HillChai/SimpleWarehouse/2_Chapter2_CALIBARATED/TEX/REWRITE.pdf

# 智能仓储系统的开发研究

先进计算与机器人研究所

2023 年 7 月 4 日

目录

1 第二章: 等待校准的秤 | 2

## 1 第二章: 等待校准的秤

从上一章 1.3 节的图像可以看出, 称重结果有些不准, 离真实数据偏差较大, 我们需要进一步校准。从 图像看出, 用直线拟合效果也能接接受。在这一章我们将给出一个可以进行一次校准的秤, 还是在 1.3 节 Calibrate 类上进行修改, 加入 kb 在 arduino 硬盘上读写的操作, 以及将校准后的结果打印在串口。

秤校准的步骤和 1.3 节相比基本类似:

- 1. 获得不准的数据数组;
- 2. 计算拟合系数;
- 3. 输出校准后的结果
1 | class Calibrate {
2 | union coeffience {
3 | unsigned long value_out;
4 | byte value_in[4];
5 | };

6
7 | private:
8 | int pin_SCK, pin_DT, range;
9 | float GapValue;
10 | unsigned long k, b;
11 | unsigned long x[13];
12 | int n;

13
14 | public:
15 | Calibrate();

16
17 | void Get_x_array(unsigned long ADS);
18 | void Get_kb();
19 | unsigned long Output_CalibratedWeight(unsigned long weight);
20 | void kb_Initialize();

21
22 | void setpin_SCKDT(int p1, int p2);
23 | void set_range(int r);
24 | unsigned long Output_Weight(unsigned long ADS);
25 | unsigned long HX711_Read();
26 | };
| 相比 1.3 节添加了两个函数, 修改了一个函数。
| • Get_kb 中加入了写入 arduino 硬盘的操作;
| • Output_CalibratedWeight 输出校准后的读数;
| • kb_Initialize 是从 arduino 硬盘上读取存的 k,b 值。
1 | void Calibrate::Get_kb(){
2 | unsigned long y[n] = {5, 15, 35, 55, 105, 574}, sum_x = 0, sum_y = 0;
3 | for (unsigned long& yi:y)
4 | sum_y+=yi;
5 | for (unsigned long& x_i:x)
6 | sum_x+=x_i;
7 | unsigned long mean_x = sum_x/n, mean_y = sum_y/n;
8 | unsigned long k1=0, k2=0;
9 | for (int i=0; i<n; ++i) {
10 | k1+=x[i]*y[i];
11 | k2+=x[i]*x[i];
12 | }
13 | k = (k1-n*mean_x*mean_y)/(k2-n*mean_x*mean_x);

14 | b = mean_y - mean_x * k;
16 | coeffience k_out;
17 | coeffience b_out;

18
19 | k_out.value_out = k;
20 | b_out.value_out = b;

21
22 | for(int i=4; i<8; i++) //判断是否与上次储存的k相同
23 | if (!(EEPROM.read(i)==k_out.value_in[i-4])) {
24 | Serial.print("newk:");
25 | Serial.println(k);
26 | for (int j=i; j<8; j++)
27 | EEPROM.write(j, k_out.value_in[j-4]);
28 | break;
29 | }

30
31 | for(int i=8; i<12; i++) //判断是否与上次储存的b相同
32 | if (!(EEPROM.read(i)==b_out.value_in[i-8])) {
33 | Serial.print("newb:");
34 | Serial.println(b);
35 | for (int j=8; j<12; j++)
36 | EEPROM.write(j, b_out.value_in[j-8]);
37 | break;
38 | }
39 | };
| 在得到 k,b 后, 用共用体 k_out, b_out 存储 k, b 值, 通过 for 循环与 arduino 上对应地址存的 k(4 7),
| b(8 11) 值比较, 如果不一样则从当前位置写入。
1 | coeffience k_out;
2 | coeffience b_out;

3
4 | k_out.value_out = k;
5 | b_out.value_out = b;

6
7 | for(int i=4; i<8; i++) //判断是否与上次储存的k相同
8 | if (!(EEPROM.read(i)==k_out.value_in[i-4])) {
9 | Serial.print("newk:");
10 | Serial.println(k);
11 | for (int j=i; j<8; j++)
12 | EEPROM.write(j, k_out.value_in[j-4]);
13 | break;
14 | }

15
16 | for(int i=8; i<12; i++) //判断是否与上次储存的b相同
17 | if (!(EEPROM.read(i)==b_out.value_in[i-8])) {
18 | Serial.print("newb:");
19 | Serial.println(b);
20 | for (int j=8; j<12; j++)
21 | EEPROM.write(j, b_out.value_in[j-8]);
22 | break;
23 | }
| 校准结果是在第一章中 Output_Weight 基础上, 加入了系数 k,b 的作用, 返回校准后的质量。
1 | unsigned long Calibrate::Output_CalibratedWeight(unsigned long ADS){
2 | return k*Output_Weight(ADS)+b;
3 | };
| 如果之前校准过, 可以通过 kb_Initialize() 读取 arduino 上存的 k,b 值:
1 | void PressureSensor::kb_Initialize() {

2 | coeffience k_arduino;
3 | coeffience b_arduino;
5 | for(int i=4; i<8; i++) {
6 | k_arduino.value_in[i-4] = EEPROM.read(i);
7 | b_arduino.value_in[i-4] = EEPROM.read(i+4);
8 | }

9
10 | k = k_arduino.value_out;
11 | b = b_arduino.value_out;
12 | Serial.print("k:␣");
13 | Serial.println(k);
14 | Serial.print("b:␣");
15 | Serial.println(b);
16 | };
| arduino 上 k 对应的地址是 4 到 7, b 对应的地址是 8 到 11。首先创建两个共用体 k_arduino,
| b_arduino。
1 | coeffience k_arduino;
2 | coeffience b_arduino;
| 然后用一个 for 循环读对应地址上信息存放到对应共用体中。
1 | for(int i=4; i<8; i++) {
2 | k_arduino.value_in[i-4] = EEPROM.read(i);
3 | b_arduino.value_in[i-4] = EEPROM.read(i+4);
4 | }
| 最后是更新变量 k,b, 并在串口打印。
1 | k = k_arduino.value_out;
2 | b = b_arduino.value_out;
3 | Serial.print("k:␣");
4 | Serial.println(k);
5 | Serial.print("b:␣");
6 | Serial.println(b);

### 1.1 Calibrate.ino

1 | #include "Surface.h"
2 | #include "Calibrate.h"

3
4 | Surface YL_Surface;
5 | Calibrate YL_Calibrated;

6
7 bool flag=1;

8
9 | void setup() {
10 | Serial.begin(9600);
11 | YL_Calibrated.setpin_SCKDT(4, 5);
12 | YL_Calibrated.set_range(20);
13 | YL_Calibrated.kb_Initialize();
14 | }

15
16 | void loop() {
17 | if (flag) {
18 | YL_Calibrated.Get_x_array(YL_Surface.Get_Surface());
19 | YL_Calibrated.Get_kb();
20 | flag=0;
21 | }

23 | unsigned long CalibratedWeight = YL_Calibrated.Output_CalibratedWeight(YL_Surface.
| Get_Surface());
24 | Serial.println(CalibratedWeight);
25 | delay(1000);
26 | }
| 主程序分为三部分:
| 第一部分: 导入头文件 Calibrate.h, Surface.h, 实例化 Surface 类. Oled 类, flag=1 方便主循环调用一次校
| 准;
1 | #include "Surface.h"
2 | #include "Calibrate.h"

3
4 | Surface YL_Surface;
5 | Calibrate YL_Calibrated;

6
7 | bool flag=1;
| 第二部分: 在 setup 函数里初始化波特率 9600, 与 Arduino 串口通信的波特率保持一致;
1 | Serial.begin(9600);
| 设置与 SCK 和 DT 相连的 arduino 引脚 4 和 5, 设置当前压力传感器的量程 20. kb_Initialize() 读
| 取之前存的 k,b 值:
1 | YL_Calibrated.setpin_SCKDT(4, 5);
2 | YL_Calibrated.set_range(20);
3 | YL_Calibrated.kb_Initialize();
| 第三部分: flag 为 1 时进行一次校准, 并在校准后 flag 赋值为 0, 避免重复校准。先通过 Get_x_array 获
| 得不准的读数数组, 再通过 Get_kb 获得拟合系数, 最后由 Output_CalibratedWeight 计算校准后的结果。
1 | if (flag) {
2 | YL_Calibrated.Get_x_array(YL_Surface.Get_Surface());
3 | YL_Calibrated.Get_kb();
4 | flag=0;
5 | }

6
7 | unsigned long CalibratedWeight = YL_Calibrated.Output_CalibratedWeight(YL_Surface.
| Get_Surface());
8 | Serial.println(CalibratedWeight);
9 | delay(1000);
10 | }
