HillChai/SimpleWarehouse/4_Chapter4_COMMUNICATION/TEX/REWRITE.pdf

# 智能仓储系统的开发研究

先进计算与机器人研究所

2023 年 7 月 9 日

目录

1 第四章: I2C 通信 | 2

## 1 第四章: I2C 通信

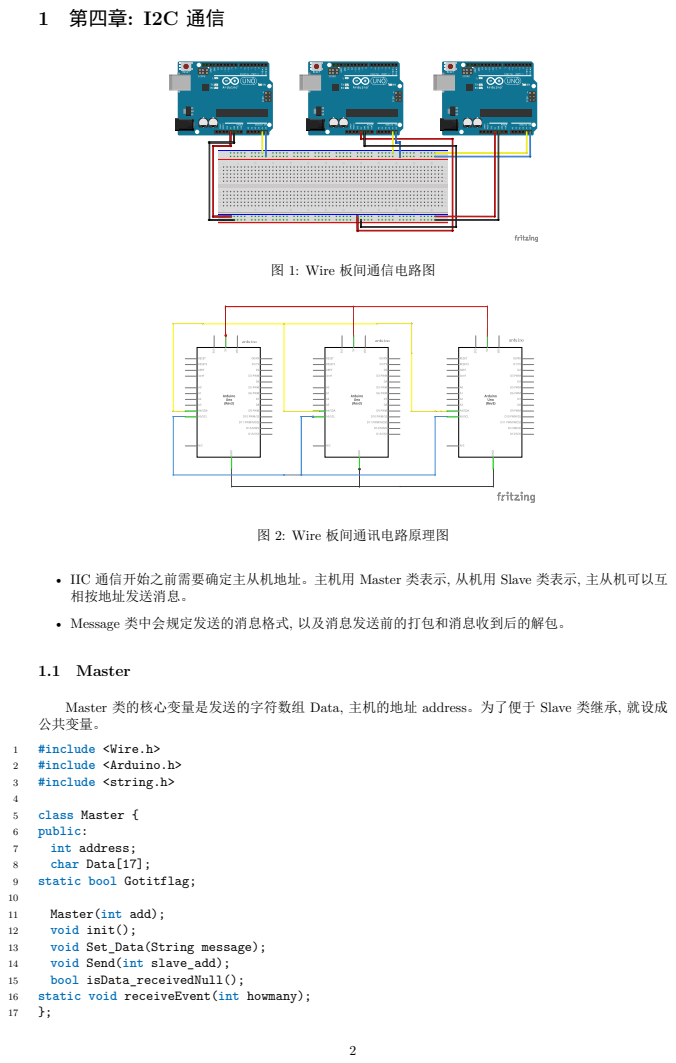
[picture p5: page 2]
图 1: Wire 板间通信电路图; 图 2: Wire 板间通讯电路原理图; 1.1 Master; #include <Wire.h>; #include <Arduino.h>; #include <string.h>; class Master {; public:; int address;; char Data[17];; static bool Gotitflag;; Master(int add);; void init();; void Set_Data(String message);; void Send(int slave_add);; bool isData_receivedNull();; static void receiveEvent(int howmany);

• IIC 通信开始之前需要确定主从机地址。主机用 Master 类表示, 从机用 Slave 类表示, 主从机可以互
相按地址发送消息。

• Message 类中会规定发送的消息格式, 以及消息发送前的打包和消息收到后的解包。

Master 类的核心变量是发送的字符数组 Data, 主机的地址 address。为了便于 Slave 类继承, 就设成
公共变量。

在构造函数 Master 中, 通过赋值更新地址 address。

1 | Master::Master(int add){
2 | address=add;
3 | };
| 由于 Wire.begin() 不能在 setup 之前运行, 所以在初始化函数 init 中初始化了 IIC 通信, 并绑定了回
| 调函数 receiveEvent, 在 IIC 收到消息时调用。
1 | void Master::init() {
2 | Wire.begin(address);
3 | Wire.onReceive(receiveEvent);
4 | memset(Data, '0', 16);
5 | };
| Set_Data 通过赋值更新 Data。
1 | void Master::Set_Data(String message) {
2 | for (int i=0; i<message.length(); i++)
3 | Data[i] = message[i];
4 | };
| Send 是主机向地址为 slave_add 的从机发送消息 Data, 为了方便判断是否发送了, 发送成功则会在
| 串口打印”Sended”, 否则就会卡住, 不打印”Sended”。
1 | void Master::Send(int slave_add) {
2 | Wire.beginTransmission(slave_add);
3 | Wire.write(Data);
4 | Wire.endTransmission(slave_add);
5 | Serial.println("Sended");
6 | };
| 为了确认从机是否收到完整消息, 在下一节从机 Slave 类中会提到, 当 Slave 确认收到了完整消息, 就
| 会向主机发送一个字符串”Gotit!”。那么相应地, 主机也需要判断接收到的是不是”Gotit!”。如果是则会将
| 一个静态变量 Gotitflag 置为 1, 在演示代码 Master.ino 中, 会再次提到 Gotitflag。
1 | bool Master::Gotitflag = 0;

2
3 | void Master::receiveEvent(int howmany){
4 | String standard = "Gotit!";
5 | String buffer = "";
6 | while (Wire.available())
7 | buffer += (char) Wire.read();
8 | Serial.println(buffer);
9 | for (int i=0; i<6; i++)
10 | if (buffer[i] == standard[i])
11 | Gotitflag = 1;
12 | };

### 1.1.1 Master.ino

演示代码实现的是地址为 8 的主机会一直向地址为 11 的从机发送字符串”SS0812345RR”, 直到 Gotitflag 置为 1。Gotitflag 置为 1 意味着从机发送回了收到的信号。则在串口打印结束发送。

1 #include "Master.h"

2
3 Master master(8);

4
5 | void setup() {
6 | Serial.begin(9600);
7 | master.init();
8 | master.Set_Data("SS0812345RR");

11 | void loop() {
12 | while (!master.Gotitflag) {
13 | master.Send(11);
14 | delay(5000);
15 | }
16 | Serial.println("endsending");
17 | delay(500);
18 | }

### 1.2 Slave

| Slave 类的核心变量是储存主机发送过来的完整消息 Data_received, 储存主机的地址 address_to_send。
| Slave 储存自身的地址变量是从 Master 类中继承过来的。
1 | #include "Master.h"

2
3 | class Slave : public Master{
4 | private:
5 | static String Data_received;

6
7 | public:
8 | static int address_to_send;

9
10 | Slave(int add);
11 | void init();
12 | void feedback();
13 | static void slave_receiveEvent(int howmany);
14 | };
| 构造函数 Slave() 完全继承于 Master 的构造函数
1 | Slave::Slave(int add) : Master(add) {};
| 初始化需要重定义, 因为回调函数 slave_receiveEvent 与 Master 类的 receiveEvent 不一样。
1 | void Slave::init(){
2 | Wire.begin(address);
3 | Wire.onReceive(slave_receiveEvent);
4 | memset(Data, '0', 16);
5 | }
| 从机的回调函数 slave_receiveEvent 需要在有消息的时候判断, 是不是”SS” 开头, 如果是, 则开始读,
| 并更新 Data_received。并在读到”RR” 时, 结束更新 Data_received。结束更新后, 需要读取指定位置表
| 示主机地址的字符。这里退出 while 循环需要严格以 Wire.available() 为准, 如果是读到完整消息就直接退
| 出, 很可能出现附录中第一节消息堵塞之陷入死循环。
1 | void Slave::slave_receiveEvent(int howmany){
2 | memset(&Data_received, 0, Data_received.length());
3 | bool addressflag = 1;
4 | while(Wire.available()) {
5 | Serial.println("connect");
6 | if (Data_received[0] != 'S' && Data_received[1] != 'S') {
7 | char start1 = (char) Wire.read();
8 | if (start1 == 'S') {
9 | char start2 = (char) Wire.read();
10 | if (start2 == 'S') {
11 | Data_received += 'S';
12 | Data_received += 'S';

17 | if (Data_received[0] == 'S' && Data_received[1] == 'S') {
18 | if (Data_received[Data_received.length()-2]=='R' && Data_received[Data_received.
| length()-1]=='R') {
19 | Wire.read();
20 | if (addressflag) {
21 | String address;
22 | for (int i=0; i<2; i++) address += Data_received[2+i];
23 | address_to_send = address.toInt();
24 | addressflag = 0;
25 | }
26 | } else {
27 | char end1 = (char) Wire.read();
28 | Data_received += end1;
29 | // Serial.println(Data_received);
30 | }
31 | }
32 | }
33 | Serial.println(address_to_send);
34 | };
| 在上一节 Master 类中有提到”Gotit!” 作为从机读到完整消息的反馈。这里 address_to_send 是先设
| 为不可能有的地址 99, 在 slave_receiveEvent 中, 如果接收到完整消息, 则 address_to_send 会更新为有
| 效地址, 所以利用 address_to_send 作为要不要发送”Gotit!” 的 flag。
1 | void Slave::feedback() {
2 | if (address_to_send!=99) {
3 | Wire.beginTransmission(address_to_send);
4 | Wire.write("Gotit!");
5 | Wire.endTransmission(address_to_send);
6 | address_to_send = 99;
7 | }
8 | };

### 1.2.1 Slave.ino

演示代码是实现 slave 接收到 IIC 通信传来得的消息后, 反馈”Gotit!” 给发送过来的主机。

1 #include "Slave.h"

2
3 Slave slave(11);

4
5 | void setup() {
6 | Serial.begin(9600);
7 | slave.init();
8 | }

9
10 | void loop() {
11 | slave.feedback();
12 | delay(500);
13 | }

### 1.3 Message

| Message 类的核心变量有 5 个, 储存完整消息的字符数组 Data, 物品种类 Type, 发送方地址 De-
| viceAddress, 物品种类 Amount, 物品总质量 TotalMass。关于字符数组的长度设置原因详见本章附录。由
| 于 unsigned long 方便转化成 char*, 而 char* 不便于计算有效长度, 故需要在转化前就通过数值确定转化
| 后的长度, 储存在 totalmass_str_len 中。

1 | #include <Arduino.h>
2 | #include <string.h>
4 | class Message {
5 | private:
6 | char Data[17];
7 | char Type[3];
8 | int DeviceAddress, Amount;
9 | unsigned long TotalMass;
10 | int totalmass_str_len;

11
12 | public:
13 | Message();

14
15 | void Set_Messagevalues(char *type, int device, int amount, unsigned long totalmass);
16 | void pack();
17 | void Output_pack();

18
19 | void Set_Data(char* message);
20 | void unpack();
21 | void Output_unpack();
22 | };
| 构造函数里会对五个核心变量储存完整消息的字符数组 Data, 物品种类 Type, 发送方地址 DeviceAd-
| dress, 物品种类 Amount, 物品总质量 TotalMass 进行赋值。这里规定消息前两位和后两位是标志位。”SS”
| 表示消息开头, ”RR” 表示消息结尾。
1 | Message::Message() {
2 | memset(Data, '0', 16);
3 | Data[0] = 'S';
4 | Data[1] = 'S';
5 | Data[14] = 'R';
6 | Data[15] = 'R';
7 | Type[0] = '0';
8 | Type[1] = '0';
9 | DeviceAddress = 0;
10 | Amount = 0;
11 | TotalMass = 0;
12 | }
| Set_Messagevalues 通过赋值更新物品种类 Type, 发送方地址 DeviceAddress, 物品种类 Amount, 物
| 品总质量 TotalMass, 长度 totalmass_str_len。
1 | void Message::Set_Messagevalues(char *type, int device, int amount, unsigned long
| totalmass) {
2 | Type[0] = type[0]; //物品种类
3 | Type[1] = type[1];

4
5 | DeviceAddress = device;
6 | Amount = amount;
7 | TotalMass = totalmass;
8 | if (totalmass<10) totalmass_str_len = 1;
9 | else if (totalmass<100) totalmass_str_len = 2;
10 | else if (totalmass<1000) totalmass_str_len = 3;
11 | else if (totalmass<10000) totalmass_str_len = 4;
12 | };
| pack 用物品种类 Type, 发送方地址 DeviceAddress, 物品种类 Amount, 物品总质量 TotalMass 更新
| Data。unsigned long 不能用 String 强制转换, 但可以用 sprintf 转化成 char*。
1 | void Message::pack() {
2 | String device_str = String(DeviceAddress);
3 | String amount_str = String(Amount);

4 | char totalmass_str[5];
5 | sprintf(totalmass_str, "%d", TotalMass);
7 | for (int i=0; i<2; i++)
8 | Data[2+i] = Type[i]; //物品种类

9
10 | int device_str_len = device_str.length();
11 | if (device_str_len == 1) { | //发送方地址
12 | Data[5] = device_str[0];
13 | }
14 | else if (device_str_len == 2) {
15 | Data[4] = device_str[0];
16 | Data[5] = device_str[1];
17 | }

18
19 | int amount_str_len = amount_str.length(); //物品数量
20 | if (amount_str_len == 1) Data[9] = amount_str[0];
21 | else if (amount_str_len == 2)
22 | for (int i=0; i<2; i++) Data[8+i] = amount_str[i];
23 | else if (amount_str_len == 3)
24 | for (int i=0; i<3; i++) Data[7+i] = amount_str[i];
25 | else if (amount_str_len == 4)
26 | for (int i=0; i<4; i++) Data[6+i] = amount_str[i];

27
28 | if (totalmass_str_len == 1) //物品总质量
29 | Data[13] = totalmass_str[0];
30 | else if (totalmass_str_len == 2)
31 | for (int i=0; i<2; i++) Data[12+i] = totalmass_str[i];
32 | else if (totalmass_str_len == 3)
33 | for (int i=0; i<3; i++) Data[11+i] = totalmass_str[i];
34 | else if (totalmass_str_len == 4)
35 | for (int i=0; i<4; i++) Data[10+i] = totalmass_str[i];
36 | };

Output_pack 将打包后的 Data 打印在串口。

1 | void Message::Output_pack() {
2 | Serial.print("Data:");
3 | Serial.println(Data);
4 | };
| Set_Data 通过赋值更新 Data。
1 | void Message::Set_Data(char* message) {
2 | for (int i=2; i<14; i++)
3 | Data[i]=message[i];
4 | }

pack 用 Data 更新物品种类 Type, 发送方地址 DeviceAddress, 物品种类 Amount, 物品总质量 Total-Mass。中间用字符串 device_str, amount_str, tm_str 过渡，然后用 toInt 转化成数值。

1 | void Message::unpack() {
2 | String device_str, amount_str;
3 | char totalmass_str[5];

4
5 | for (int i=0; i<2; i++)
6 | Type[i] = Data[2+i];

7
8 | for (int i=0; i<2; i++)
9 | device_str += Data[4+i];
10 | DeviceAddress = device_str.toInt();
12 | for (int i=0; i<4; i++)

13 | amount_str += Data[6+i];
14 | Amount = amount_str.toInt();
16 | String tm_str;
17 | for (int i=10; i<14; i++)
18 | tm_str += Data[i];
19 | TotalMass = tm_str.toInt();
20 | };
| Output_unpack 将打包后的物品种类 Type, 发送方地址 DeviceAddress, 物品种类 Amount, 物品总
| 质量 TotalMass 打印在串口。
1 | void Message::Output_unpack() {
2 | Serial.print("Type:");
3 | Serial.println(Type);
4 | Serial.print("DeviceAddress:");
5 | Serial.println(DeviceAddress);
6 | Serial.print("Amount:");
7 | Serial.println(Amount);
8 | Serial.print("TotalMass:");
9 | Serial.println(TotalMass);
10 | };

### 1.3.1 Message.ino

演示代码 1 是实现消息发送前的打包:

1 #include "Message.h"

2
3 Message message;

4
5 | char type[2] = {'0', '3'}; //unpack
6 | int address = 8;
7 | int num = 321;
8 | unsigned long totalmass=19;

9
10 | void setup() {
11 | Serial.begin(9600);
12 | message.Set_Messagevalues(type, address, num, totalmass); //pack
13 | message.pack();
14 | }

15
16 | void loop() {
17 | message.Output_pack(); //pack
18 | delay(500);
19 | }
| 演示代码 2 是实现消息收到后的解包:
1 | #include "Message.h"

2
3 Message message;

4
5 | char data[17] = {'S','S','0','4','0','9','0','5','0','5','2','0','0','0','R','R'}; //
| pack

6
7 | void setup() {
8 | Serial.begin(9600);
9 | message.Set_Data(data); //unpack
10 | message.unpack();

13 | void loop() {
14 | message.Output_unpack(); //unpack
15 | delay(500);
16 | }

### 1.4 附录

| 1.4.1 IIC 通信之消息堵塞
| 遇到过的消息堵塞有两种情况。
| • 接发消息一方陷于死循环;
| • 主从机同时用 Wire.beginTransmis() 向对方发消息。
| 比如, 主机发消息是一个字符一个字符发的, 而从机是通过 Wire.read() 一个字符一个字符读的。如果从
| 机一直判断当前读取的字符是不是所需要的字符而不用 Wire.read() 读取的话, 就会造成死循环。只有用
| Wire.read() 读完了上一次发送的消息里的所有字符, 才能读到下一次发送的消息。
| 1.4.2 字符数组的长度
| 字符数组的长度这里要设置的比实际储存的长度长, 如果字符数组的长度这里要设置的比实际储存的
| 长度一样的话, 会出现问题, 比如, Type 字符数组在 Data 字符数组的后面声明的话, 当 Type 在某一方法
| 函数里赋值的时候, 会使得 Data 字符数组的结尾追加 Type 新赋值的字符。而当字符数组的长度这里要
| 设置的比实际储存的长度长时, 字符数组中未赋值的部分会自动填充结尾终止符斜杠 0, 这样就不会赋值
| 时互相影响。
