HillChai/SimpleWarehouse/5_Chapter5_RC522/TEX/REWRITE.pdf

# 智能仓储系统的开发研究

先进计算与机器人研究所

2023 年 7 月 4 日

目录

1 第五章: 射频识别技术 (RFID-RC522) | 2

## 1 第五章: 射频识别技术 (RFID-RC522)

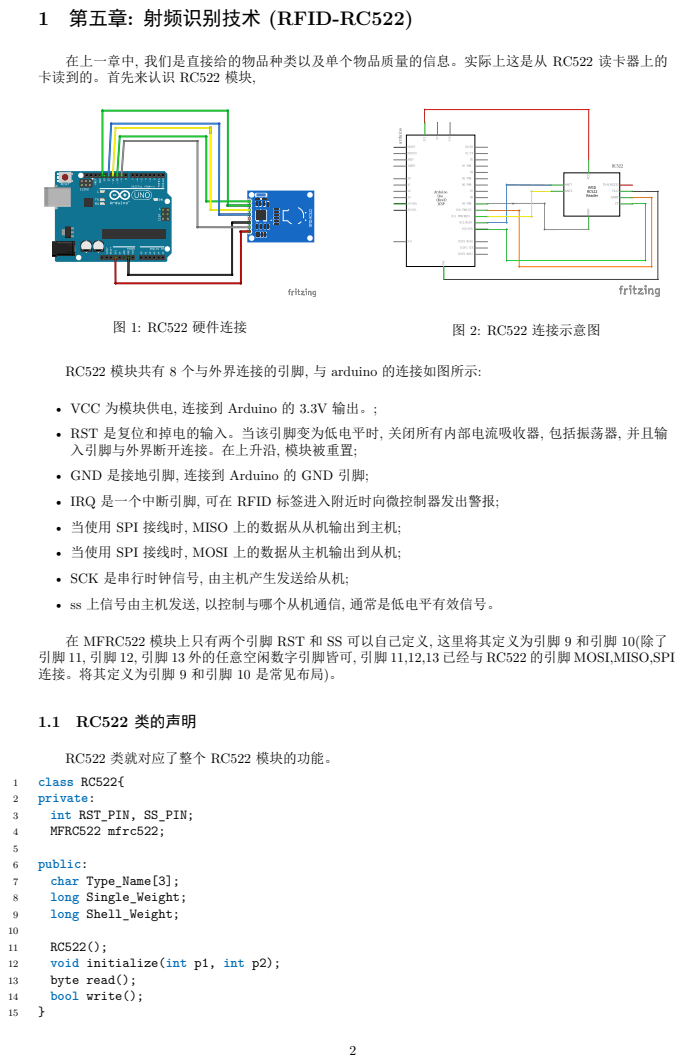
[picture p6: page 2]
图 1: RC522 硬件连接; 图 2: RC522 连接示意图; 1.1 RC522 类的声明; RC522 类就对应了整个 RC522 模块的功能。; class RC522{; private:; int RST_PIN, SS_PIN;; MFRC522 mfrc522;; public:; char Type_Name[3];; long Single_Weight;; long Shell_Weight;; void initialize(int p1, int p2);; byte read();; bool write();

在上一章中, 我们是直接给的物品种类以及单个物品质量的信息。实际上这是从 RC522 读卡器上的
卡读到的。首先来认识 RC522 模块,

RC522 模块共有 8 个与外界连接的引脚, 与 arduino 的连接如图所示:

• VCC 为模块供电, 连接到 Arduino 的 3.3V 输出。;
• RST 是复位和掉电的输入。当该引脚变为低电平时, 关闭所有内部电流吸收器, 包括振荡器, 并且输
入引脚与外界断开连接。在上升沿, 模块被重置;
• GND 是接地引脚, 连接到 Arduino 的 GND 引脚;
• IRQ 是一个中断引脚, 可在 RFID 标签进入附近时向微控制器发出警报;
• 当使用 SPI 接线时, MISO 上的数据从从机输出到主机;
• 当使用 SPI 接线时, MOSI 上的数据从主机输出到从机;
• SCK 是串行时钟信号, 由主机产生发送给从机;
• ss 上信号由主机发送, 以控制与哪个从机通信, 通常是低电平有效信号。

在 MFRC522 模块上只有两个引脚 RST 和 SS 可以自己定义, 这里将其定义为引脚 9 和引脚 10(除了
引脚 11, 引脚 12, 引脚 13 外的任意空闲数字引脚皆可, 引脚 11,12,13 已经与 RC522 的引脚 MOSI,MISO,SPI
连接。将其定义为引脚 9 和引脚 10 是常见布局)。

- 私有变量: RST_PIN, SS_PIN 分别是与 RC522 的 RST,SS 连接的 arduino 引脚;
- 公共变量: Type_Name, Single_Weight, Shell_Weight 是储存从读卡器中读到的物品种类, 单个物 品质量, 每一层物品质量;

默认构造函数:

1 | RC522::RC522(){};
| 初始化函数用于引脚的赋值, 初始化 SPI 通信, 初始化 MFRC522 类。
1 | void RC522::initialize(int p1, int p2){
2 | RST_PIN=p1;
3 | SS_PIN=p2;
4 | SPI.begin();
5 | mfrc522 = MFRC522(SS_PIN, RST_PIN);
6 | mfrc522.PCD_Init();
7 | };

### 1.2 读卡模式

| 将下述代码烧录运行, 就做好了读卡准备。
1 | byte RC522::read(){
2 | // init the read state
3 | byte read_state = 0;
4 | //default key
5 | MFRC522::MIFARE_Key key;
6 | for (byte i = 0; i < 6; ++i) key.keyByte[i] = 0xFF;
7 | //some variables we need
8 | byte block;
9 | byte len;
10 | MFRC522::StatusCode status;
11 | //-------------------------------------------
12 | // Reset the loop if no new card present on the sensor/reader. This saves the entire
| process when idle.
13 | if ( ! mfrc522.PICC_IsNewCardPresent()) {
14 | return read_state;
15 | }
16 | // Select one of the cards
17 | if ( ! mfrc522.PICC_ReadCardSerial()) {
18 | return read_state ;
19 | }
20 | // read one card
21 | read_state = 1;
22 | Serial.println(F("**Card␣Detected:**"));
23 | //-------------------------------------------
24 | // mfrc522.PICC_DumpDetailsToSerial(&(mfrc522.uid)); //dump some details about the
| card
25 | // mfrc522.PICC_DumpToSerial(&(mfrc522.uid)); //uncomment this to see all blocks in
| hex
26 | //-------------------------------------------

27
28 | byte buffer1[18];
29 | block = 1;
30 | len = 18;
31 | //------------------------------------------- GET TYPE NAME
32 | status = mfrc522.PCD_Authenticate(MFRC522::PICC_CMD_MF_AUTH_KEY_A, block, &key, &(
| mfrc522.uid)); //line 834 of MFRC522.cpp file
33 | if (status != MFRC522::STATUS_OK) {
34 | Serial.print(F("Authentication␣failed:␣"));

35 | Serial.println(mfrc522.GetStatusCodeName(status));
36 | return read_state;
37 | }
38 | status = mfrc522.MIFARE_Read(block, buffer1, &len);
39 | if (status != MFRC522::STATUS_OK) {
40 | Serial.print(F("Reading␣failed:␣"));
41 | Serial.println(mfrc522.GetStatusCodeName(status));
42 | return read_state;
43 | }
44 | //PRINT TYPE NAME
45 | Type_Name[0] = buffer1[0];
46 | Type_Name[1] = buffer1[1];
47 | long singleweight = 0;
48 | for (uint8_t i = 2; i < 6; ++i)
49 | {
50 | singleweight = singleweight*10 + (buffer1[i]-48);
51 | }
52 | Single_Weight = singleweight;
53 | Serial.print(F("Type␣Name:␣"));
54 | Serial.println(Type_Name);
55 | Serial.print(F("Type␣Single␣Weight:␣"));
56 | Serial.println(Single_Weight);
57 | //---------------------------------------- GET WEIGHT

58
59 | byte buffer2[18];
60 | block = 4;
61 | status = mfrc522.PCD_Authenticate(MFRC522::PICC_CMD_MF_AUTH_KEY_A, block, &key, &(
| mfrc522.uid)); //line 834
62 | if (status != MFRC522::STATUS_OK) {
63 | Serial.print(F("Authentication␣failed:␣"));
64 | Serial.println(mfrc522.GetStatusCodeName(status));
65 | return read_state;
66 | }
67 | status = mfrc522.MIFARE_Read(block, buffer2, &len);
68 | if (status != MFRC522::STATUS_OK) {
69 | Serial.print(F("Reading␣failed:␣"));
70 | Serial.println(mfrc522.GetStatusCodeName(status));
71 | return read_state;
72 | }
73 | //PRINT WEIGHT
74 | int shellweight = 0;
75 | for (uint8_t i = 1; i < 16; ++i) {
76 | // Serial.write(buffer2[i] );
77 | // Serial.println();
78 | // Serial.println(buffer2[i]);
79 | if(buffer2[i] == 32) break;
80 | shellweight = shellweight*10 + (buffer2[i]-48);
81 | }
82 | Shell_Weight = shellweight;
83 | Serial.print(F("Shell␣Weight:␣"));
84 | Serial.println(Shell_Weight);
85 | //----------------------------------------
86 | Serial.println(F("**End␣Reading**\n"));
87 | read_state = 2;
88 | mfrc522.PICC_HaltA();
89 | mfrc522.PCD_StopCrypto1();
90 | return read_state;
91 | }

### 1.3 写卡模式

将下述代码烧录运行, 就做好了写卡准备。写卡时会在串口提示输入两次字符串, 每次都是以 # 结尾。 第一次是输入物品种类以及单个物品质量, 例如’AA0010#’ 表示物品种类是’AA’, 单个物品质量是 10g; 第 二次是输入外壳质量, 例如’0#’ 表示外壳质量是 0。

1 | bool RC522::write(){
2 | //初始化读卡状态
3 | //未读到卡为0，读到卡为1
4 | bool write_state = 0;
5 | //创建访问密钥，用于验证并访问 MIFARE Classic RFID标签
6 | //这里用默认卡密钥
7 | MFRC522::MIFARE_Key key;
8 | for (byte i = 0; i < 6; i++) key.keyByte[i] = 0xFF;

9
10 | //block为卡的不同区域编号
11 | //len3为读到的字节数
12 | //status为判断对卡操作是否成功完成的状态变量
13 | byte block;
14 | byte len3;
15 | MFRC522::StatusCode status;

16
17 | // 如果传感器/读卡器上没有新卡，则复位循环。这可以在空闲时保存整个进程。
18 | if ( ! mfrc522.PICC_IsNewCardPresent()) {
19 | return write_state;
20 | }

21
22 | // 选择一张卡片进行读取
23 | if ( ! mfrc522.PICC_ReadCardSerial()) {
24 | return write_state;
25 | }

26
27 | Serial.println(F("**Card␣Detected:**"));
28 | // 成功读取到卡片，将读卡状态设为1
29 | write_state = 1;

30
31 | //打印UID编号
32 | Serial.print(F("Card␣UID:"));
33 | for (byte i = 0; i < mfrc522.uid.size; i++) {
34 | Serial.print(mfrc522.uid.uidByte[i] < 0x10 ? "␣0" : "␣");
35 | Serial.print(mfrc522.uid.uidByte[i], HEX);
36 | }
37 | //打印PICC类型
38 | Serial.print(F("␣PICC␣type:␣"));
39 | MFRC522::PICC_Type piccType = mfrc522.PICC_GetType(mfrc522.uid.sak);
40 | Serial.println(mfrc522.PICC_GetTypeName(piccType));

41
42 | byte buffer3[34];
43 | //等待20秒从串口输入
44 | Serial.setTimeout(20000L) ;
45 | // 提示:输入类型名称
46 | Serial.println(F("Type␣name,␣ending␣with␣#"));
47 | //从串口读入类型名称到buffer3，len为写入字节长度
48 | len3 = Serial.readBytesUntil('#', (char *) buffer3, 30) ;
49 | // 将未满字节用空格填补
50 | for (byte i = len3; i < 30; i++) buffer3[i] = '␣';

51
52 | block = 1;
53 | //选择读取区域和密钥进行身份验证，验证失败打印错误信息并提前终止
54 | status = mfrc522.PCD_Authenticate(MFRC522::PICC_CMD_MF_AUTH_KEY_A, block, &key, &(
| mfrc522.uid));

if (status != MFRC522::STATUS_OK) { Serial.print(F("PCD_Authenticate()␣failed:␣")); Serial.println(mfrc522.GetStatusCodeName(status)); return write_state;
}
else Serial.println(F("PCD_Authenticate()␣success:␣"));

// 对前述验证成功的区域内的信息写入字节数组，写入失败打印错误信息并提前终止 status = mfrc522.MIFARE_Write(block, buffer3, 16);
if (status != MFRC522::STATUS_OK) { Serial.print(F("MIFARE_Write()␣failed:␣")); Serial.println(mfrc522.GetStatusCodeName(status)); return write_state;
}
else Serial.println(F("MIFARE_Write()␣success:␣"));

block = 2;
//选择读取区域和密钥进行身份验证，验证失败打印错误信息并提前终止
status = mfrc522.PCD_Authenticate(MFRC522::PICC_CMD_MF_AUTH_KEY_A, block, &key, &( mfrc522.uid));
if (status != MFRC522::STATUS_OK) { Serial.print(F("PCD_Authenticate()␣failed:␣")); Serial.println(mfrc522.GetStatusCodeName(status));
return write_state;
}

// 对前述验证成功的区域内的信息写入字节数组的地址，写入失败打印错误信息并提前终止 status = mfrc522.MIFARE_Write(block, &buffer3[16], 16);
if (status != MFRC522::STATUS_OK) { Serial.print(F("MIFARE_Write()␣failed:␣")); Serial.println(mfrc522.GetStatusCodeName(status)); return write_state;
}
else Serial.println(F("MIFARE_Write()␣success:␣"));

byte buffer4[34];
byte len4;
// Ask personal data: First name Serial.println(F("Type␣Weight,␣ending␣with␣#"));
len4 = Serial.readBytesUntil('#', (char *) buffer4, 20) ; // read first name from serial
for (byte i = len4; i < 20; i++) buffer4[i] = '␣'; // pad with spaces

block = 4;
//选择读取区域和密钥进行身份验证，验证失败打印错误信息并提前终止
status = mfrc522.PCD_Authenticate(MFRC522::PICC_CMD_MF_AUTH_KEY_A, block, &key, &( mfrc522.uid));
if (status != MFRC522::STATUS_OK) { Serial.print(F("PCD_Authenticate()␣failed:␣")); Serial.println(mfrc522.GetStatusCodeName(status));
return write_state;
}

// 对前述验证成功的区域内的信息写入字节数组，写入失败打印错误信息并提前终止 status = mfrc522.MIFARE_Write(block, buffer4, 16);
if (status != MFRC522::STATUS_OK) { Serial.print(F("MIFARE_Write()␣failed:␣")); Serial.println(mfrc522.GetStatusCodeName(status)); return write_state;
}
else Serial.println(F("MIFARE_Write()␣success:␣"));

block = 5;
//选择读取区域和密钥进行身份验证，验证失败打印错误信息并提前终止
status = mfrc522.PCD_Authenticate(MFRC522::PICC_CMD_MF_AUTH_KEY_A, block, &key, &( mfrc522.uid));
if (status != MFRC522::STATUS_OK) { Serial.print(F("PCD_Authenticate()␣failed:␣")); Serial.println(mfrc522.GetStatusCodeName(status));
return write_state;
}

// 对前述验证成功的区域内的信息写入字节数组的地址，写入失败打印错误信息并提前终止 status = mfrc522.MIFARE_Write(block, &buffer4[16], 16);
if (status != MFRC522::STATUS_OK) { Serial.print(F("MIFARE_Write()␣failed:␣")); Serial.println(mfrc522.GetStatusCodeName(status)); return write_state;
}
else Serial.println(F("MIFARE_Write()␣success:␣")); delay(1000);

//--------------成功完成读取----------------Serial.println(F("\n**End␣Reading**\n")); //停止响应当前正在运行的命令。
//将 RFID 卡片置于休眠状态，以便进行下一个命令的执行。 mfrc522.PICC_HaltA();
//停止当前正在进行的加密。如果 RFID 模块正在与 RFID 卡片进行加密通信， //则此代码将停止加密，并将模块置于初始状态，以便进行下一个操作。 mfrc522.PCD_StopCrypto1();
//返回写卡状态
return write_state;
}

### 1.4 RC522.ino

在上一章 master.ino 基础上, 加入了通过读卡获得 rc522 的 Single_Weight 和 Type_Name。并通过 rflag 是否为 1 判断是读还是写。目前有一点不妥的是, 当没有读到卡时, 在 switch 语句中会一直在 while 中循环直到读到卡。也就是说即使物品总质量发生变化, 也只有在重新放卡后才能发送消息到上位机, 要 不然出不了 while 循环语句。

#include "master.h"

#include "transform.h"

#include "Surface.h"

#include "Calibrate.h"

#include "Oled.h"

#include "RC522.h"

master m1;
Surface YL_Surface;
Calibrate YL_Calibrated;
transform tf;
Oled oled;
RC522 rc522;

long numbefore=0, numnow=1;
char te[3];
unsigned long Sweight;
bool rflag=1; //1 ---> read; 0 ---> write

void setup() {

21 | Serial.begin(9600);
22 | m1.initialize(8); //8needschanged
23 | YL_Calibrated.setpin_SCKDT(4, 5);
24 | YL_Calibrated.set_range(20);
25 | YL_Calibrated.kb_Initialize();
26 | oled.initialize();
27 | rc522.initialize(9,10);
28 | }

29
30 | void loop() {
31 | switch(rflag){
32 | case 0:
33 | while(1) {
34 | bool state = rc522.write();
35 | if(state==1)
36 | break;
37 | }
38 | rflag=1;
39 | break;
40 | case 1:
41 | while(1) {
42 | bool state = rc522.read();
43 | if(state==1)
44 | break;
45 | }
46 | break;
47 | }
48 | for (int i=0; i<sizeof(rc522.Type_Name);i++) te[i]=rc522.Type_Name[i];
49 | Sweight=rc522.Single_Weight;

50
51 | numbefore = numnow;
52 | unsigned long CalibratedWeight = YL_Calibrated.Output_CalibratedWeight(YL_Surface.
| Get_Surface());
53 | numnow = ceil(CalibratedWeight/Sweight);

54
55 | bool flag= (numbefore==numnow?0:1);
56 | if(flag){
57 | tf.initialize(te, m1.address, numnow, CalibratedWeight);
58 | tf.pack();
59 | digitalWrite(3,HIGH);
60 | m1.send(9, tf.Transmission_Information);
61 | Serial.println(tf.Transmission_Information);
62 | oled.showIIC(te, numnow);
63 | digitalWrite(3,LOW);
64 | }

65
66 | delay(3000);
67 | }
