HillChai/SimpleWarehouse/1_Chapter1/Picture/draw.png

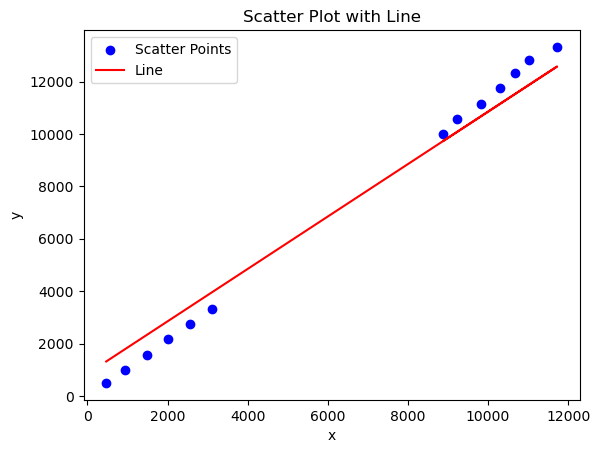
1_Chapter1/Picture/draw.png
