HillChai/SimpleWarehouse/4_Chapter4_COMMUNICATION/Picture/tca9548a1.png

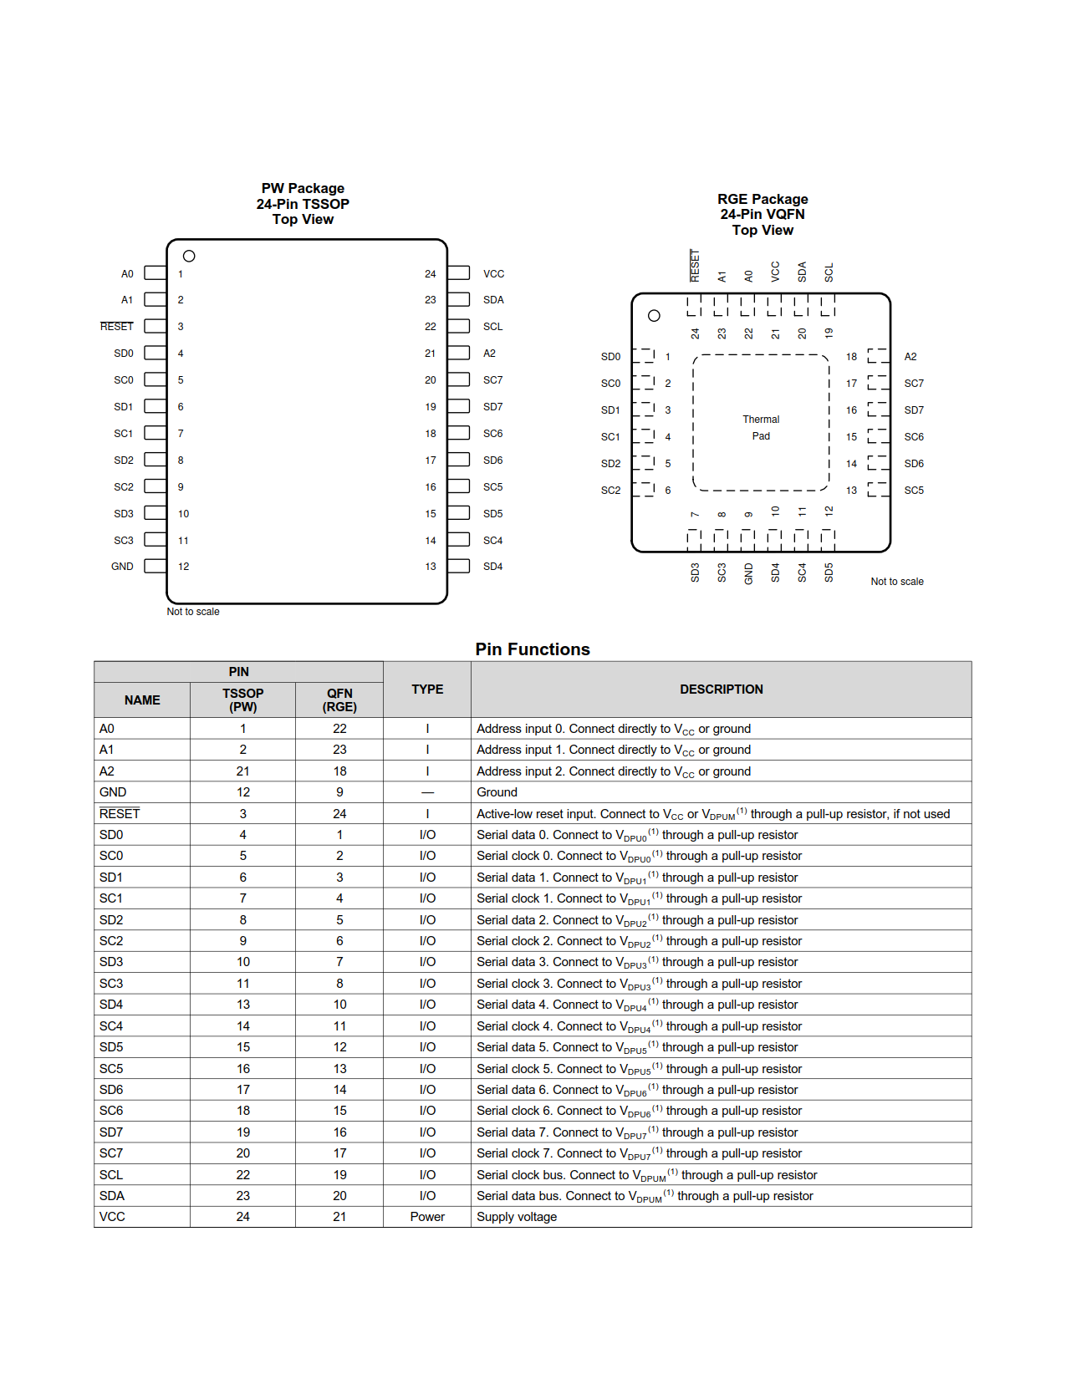
4_Chapter4_COMMUNICATION/Picture/tca9548a1.png
