HillChai/SimpleWarehouse/4_Chapter4_COMMUNICATION/Picture/tca9548a2.png

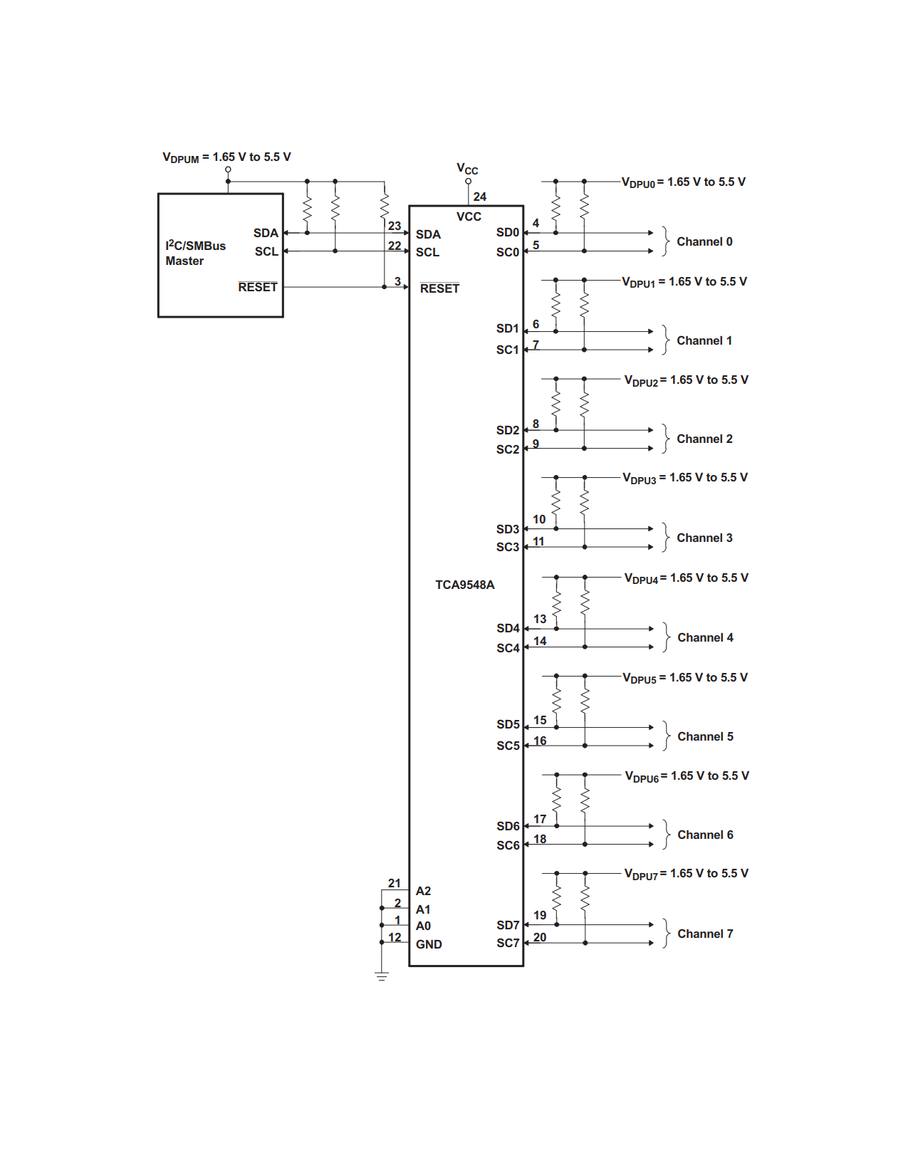
4_Chapter4_COMMUNICATION/Picture/tca9548a2.png
