HillChai/SimpleWarehouse/TEX/picture/AOA原理.png

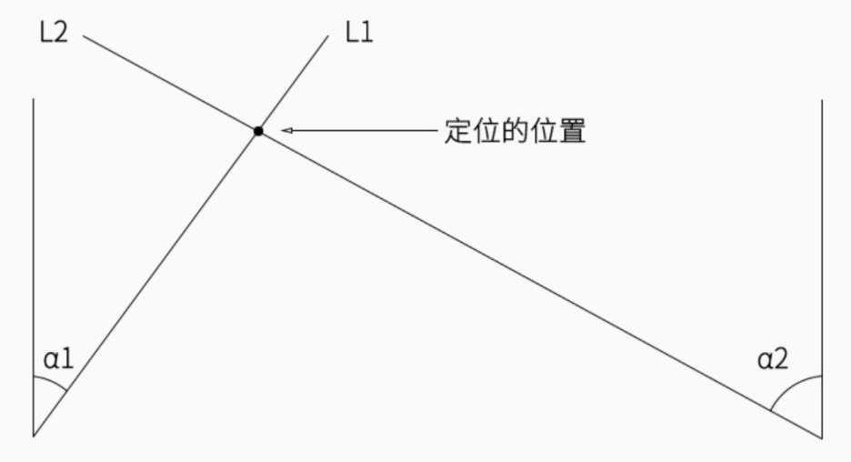
TEX/picture/AOA原理.png
