HillChai/SimpleWarehouse/TEX/picture/dark_blue.png

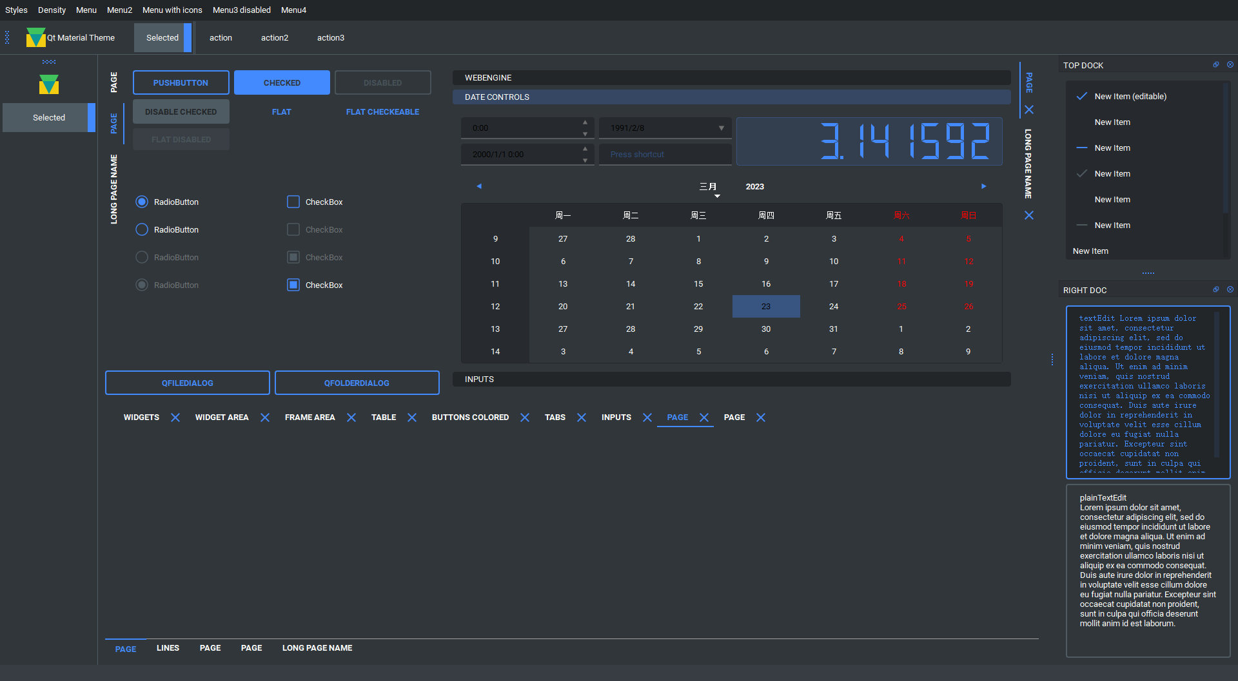
TEX/picture/dark_blue.png
