HillChai/SimpleWarehouse/TEX/picture/graph-simple(1).png

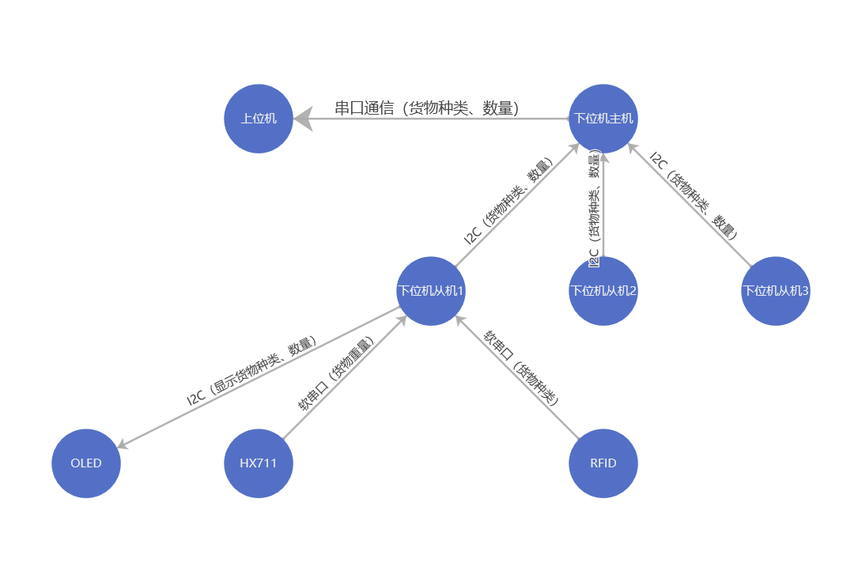
TEX/picture/graph-simple(1).png
