HillChai/SimpleWarehouse/TEX/picture/graph-simple.png

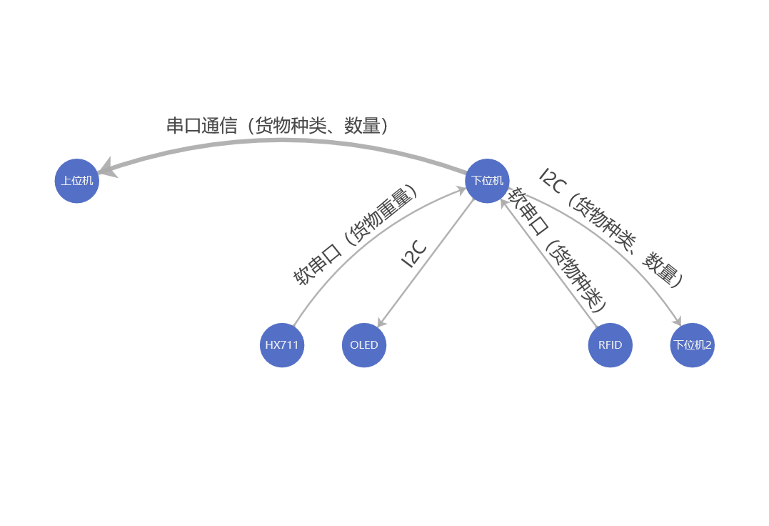
TEX/picture/graph-simple.png
