HillChai/SimpleWarehouse/TEX/picture/I2C总线的位传输.png

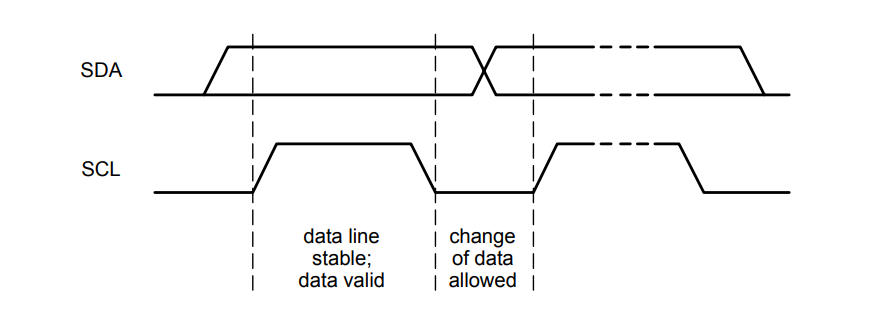
TEX/picture/I2C总线的位传输.png
