HillChai/SimpleWarehouse/TEX/picture/TDoA原理.png

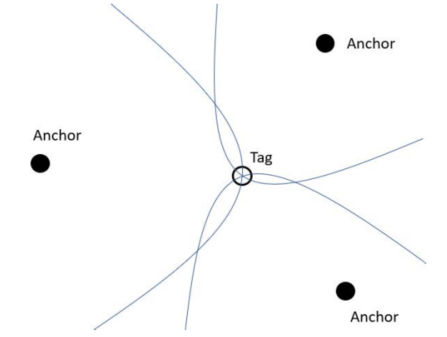
TEX/picture/TDoA原理.png
