HillChai/SimpleWarehouse/TEX/picture/TOA原理.png

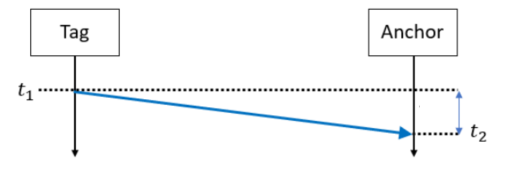
TEX/picture/TOA原理.png
