HillChai/SimpleWarehouse/TEX/picture/Trilateration三边测量定位算.png

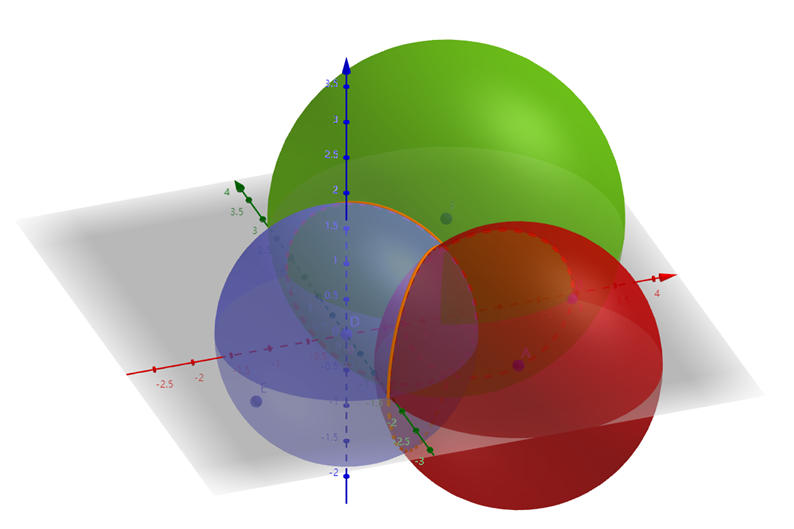
TEX/picture/Trilateration三边测量定位算.png
