HillChai/SimpleWarehouse/TEX/picture/Wire1.png

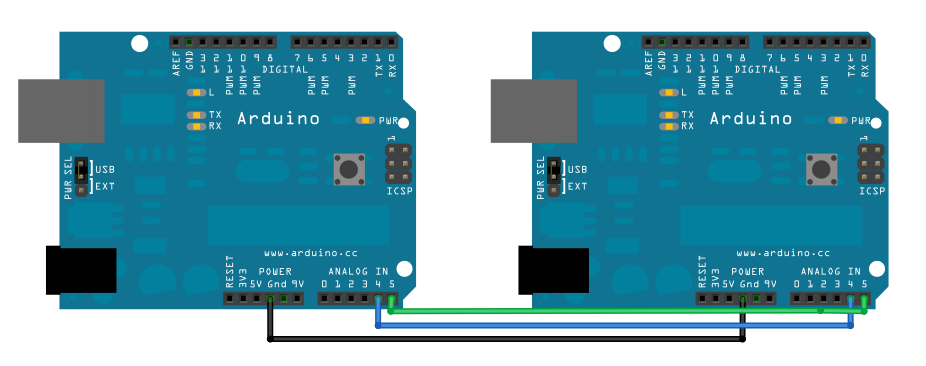
TEX/picture/Wire1.png
