HillChai/SimpleWarehouse/TEX/picture/Wire2.png

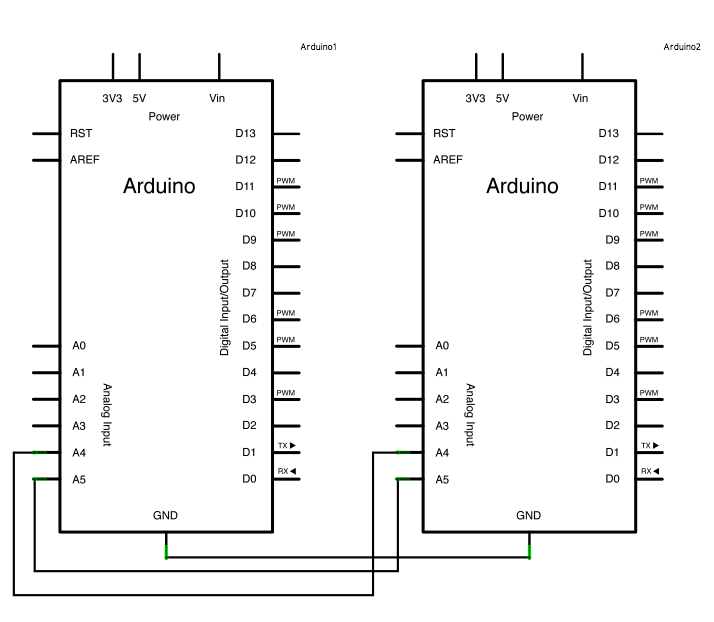
TEX/picture/Wire2.png
