HillChai/SimpleWarehouse/TEX/picture/上位机demo.png

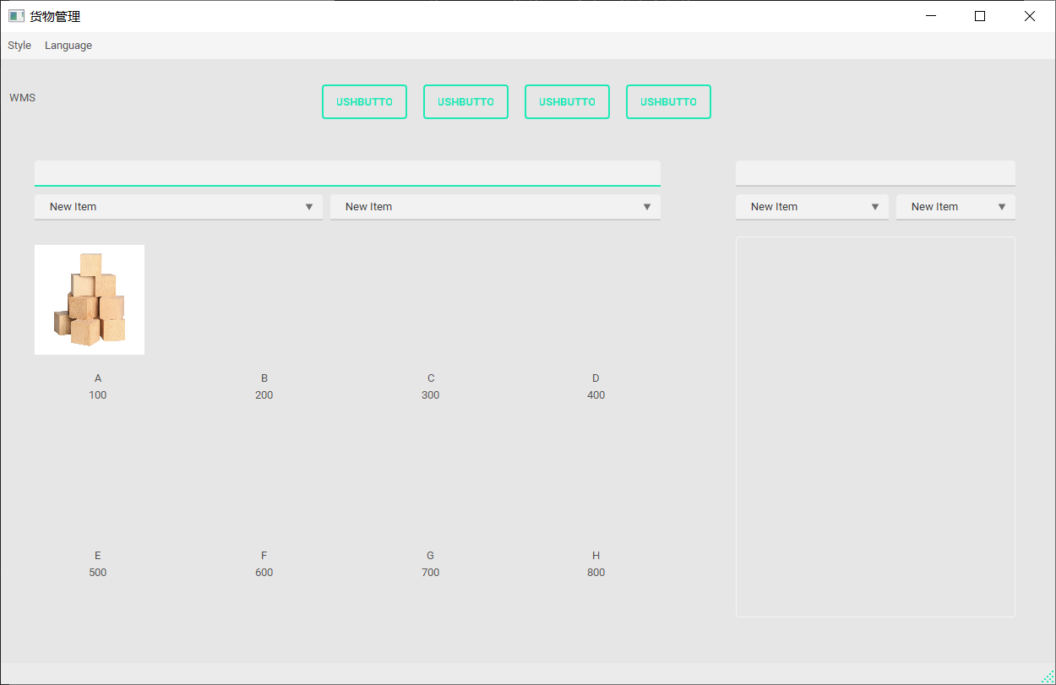
TEX/picture/上位机demo.png
