HillChai/SimpleWarehouse/TEX/picture/两个主机的仲裁过程.png

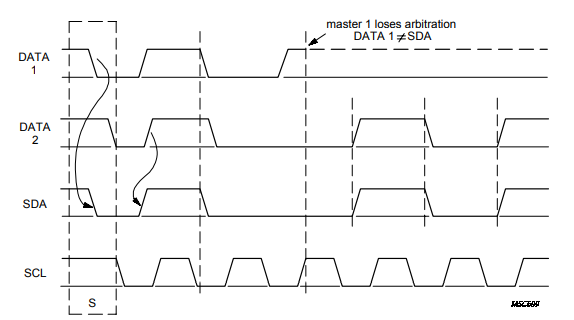
TEX/picture/两个主机的仲裁过程.png
