HillChai/SimpleWarehouse/TEX/picture/仲裁过程中的时钟同步.png

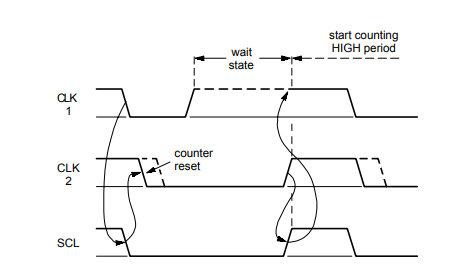
TEX/picture/仲裁过程中的时钟同步.png
