HillChai/SimpleWarehouse/TEX/picture/标准模式器件和快速模式器件连接到 I2C总线.png

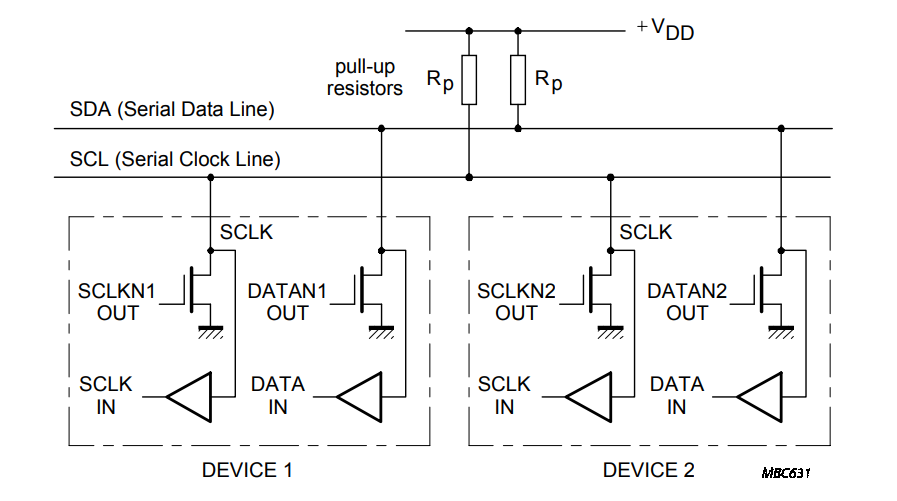
TEX/picture/标准模式器件和快速模式器件连接到 I2C总线.png
