HillChai/SimpleWarehouse/TEX/picture/起始和停止条件.png

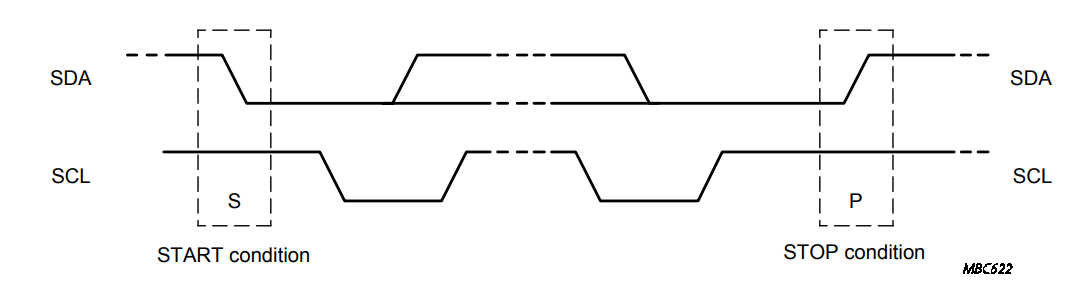
TEX/picture/起始和停止条件.png
