HillChai/SimpleWarehouse/1_Chapter1/Picture/PressureSensor.pdf

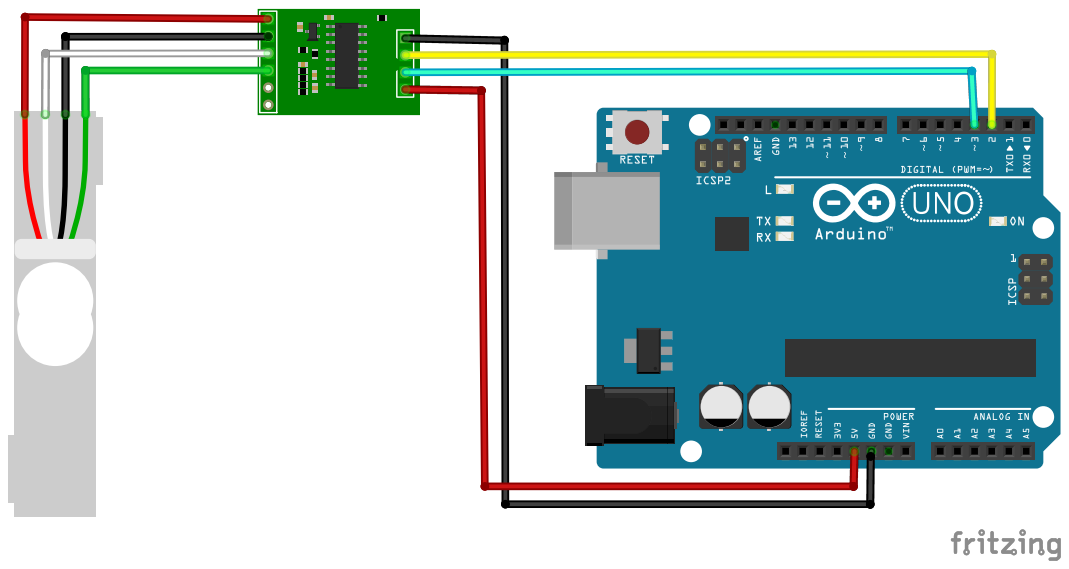
[picture p29: page 1]
