HillChai/SimpleWarehouse/3_Chapter3_DISPLAY/Picture/OLED.pdf

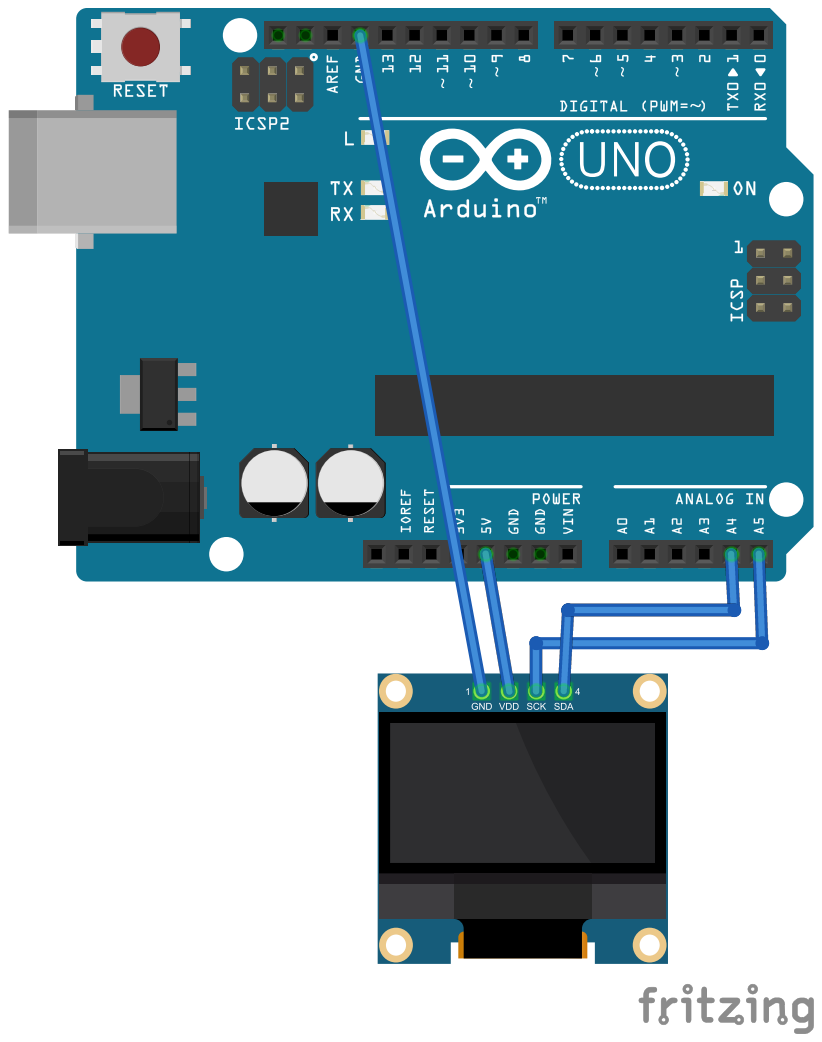
[picture p30: page 1]
