HillChai/SimpleWarehouse/4_Chapter4_COMMUNICATION/Picture/I2C_.pdf

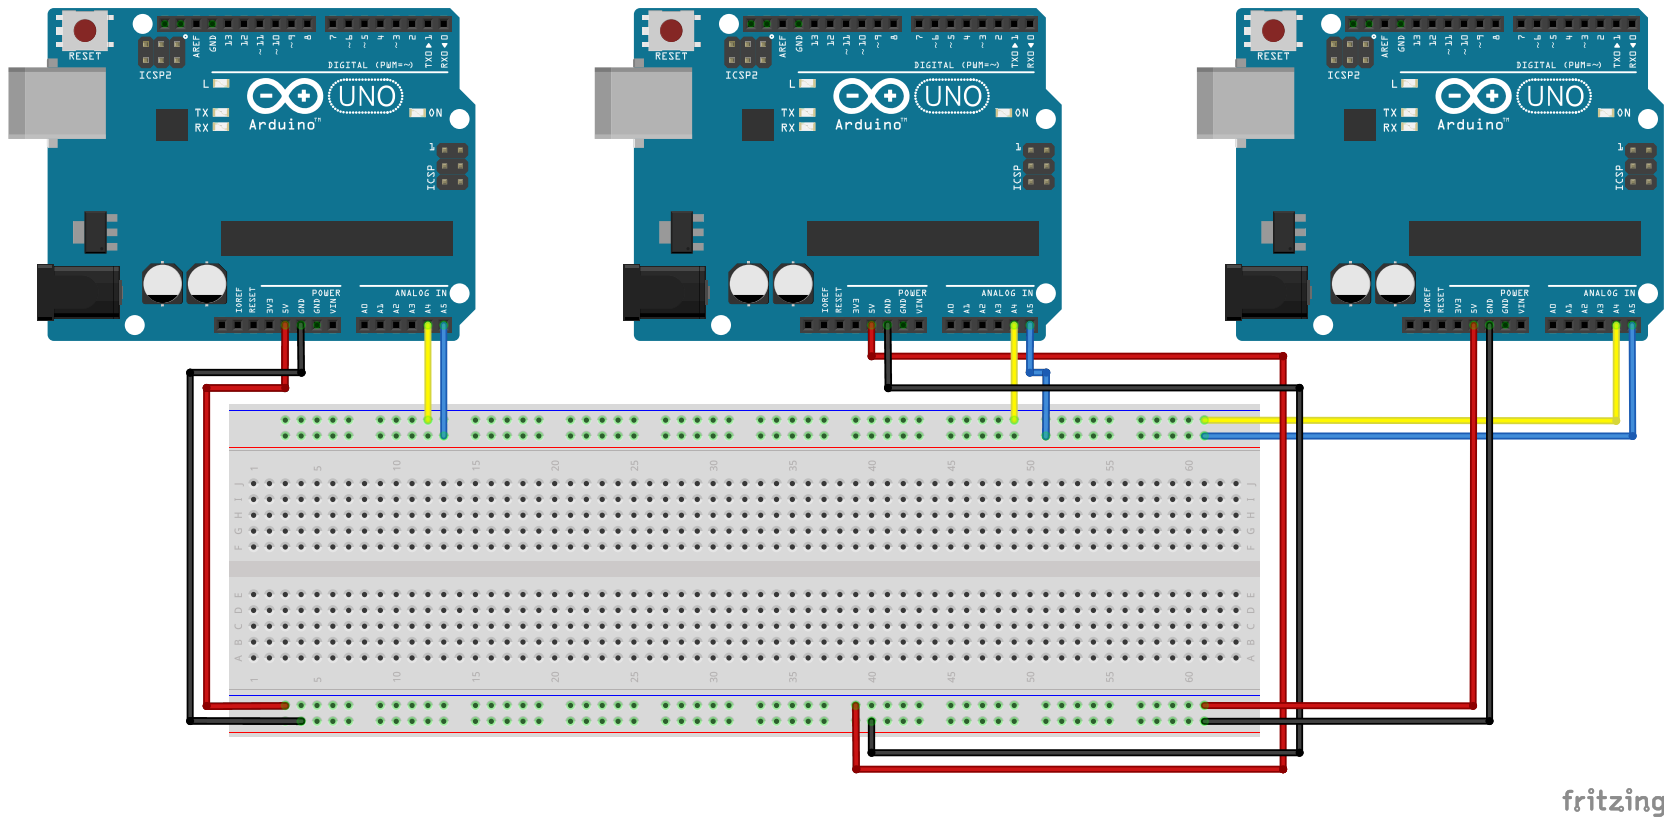
[picture p31: page 1]
