HillChai/SimpleWarehouse/4_Chapter4_COMMUNICATION/Picture/I2C_line.pdf

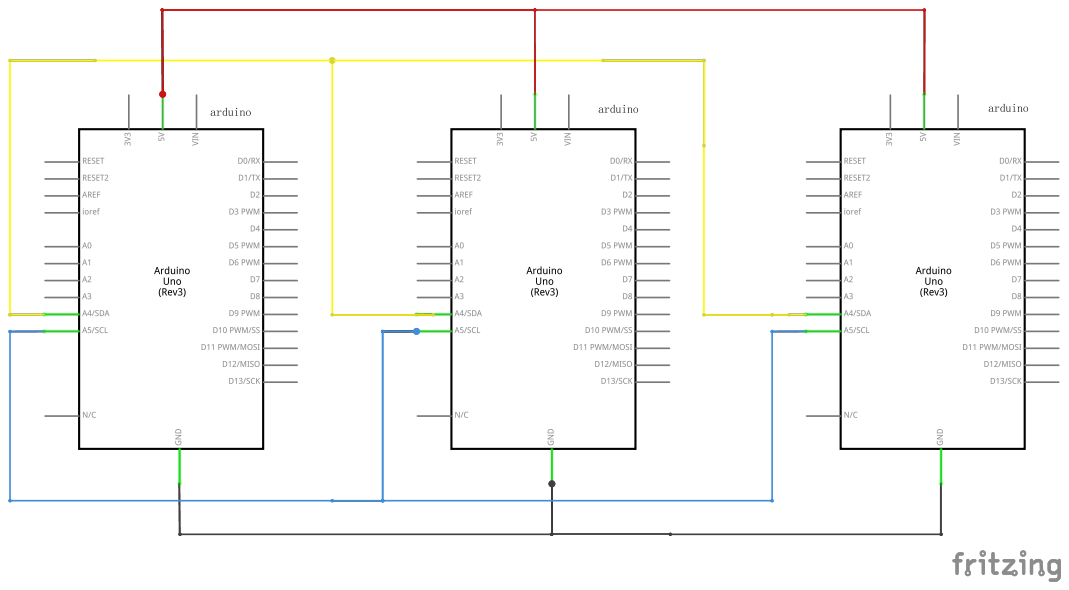
[picture p32: page 1]
