HillChai/SimpleWarehouse/4_Chapter4_COMMUNICATION/Picture/MOS.pdf

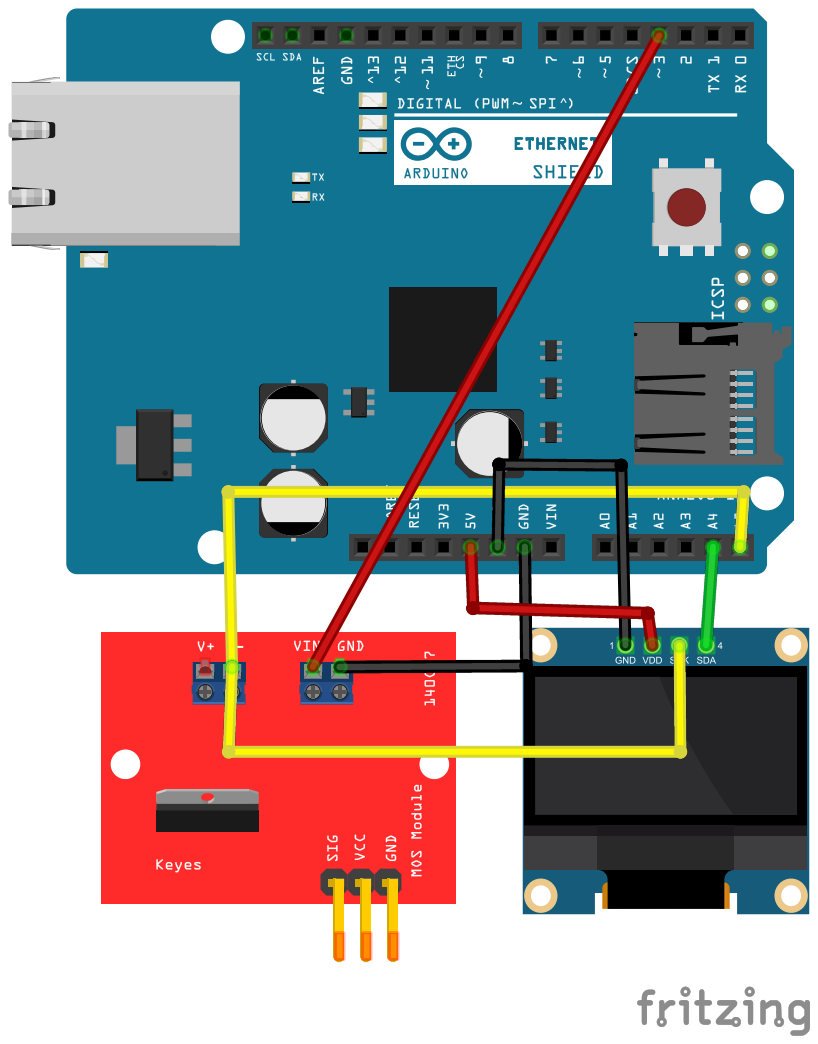
[picture p33: page 1]
