HillChai/SimpleWarehouse/4_Chapter4_COMMUNICATION/Picture/一层货架示意图.pdf

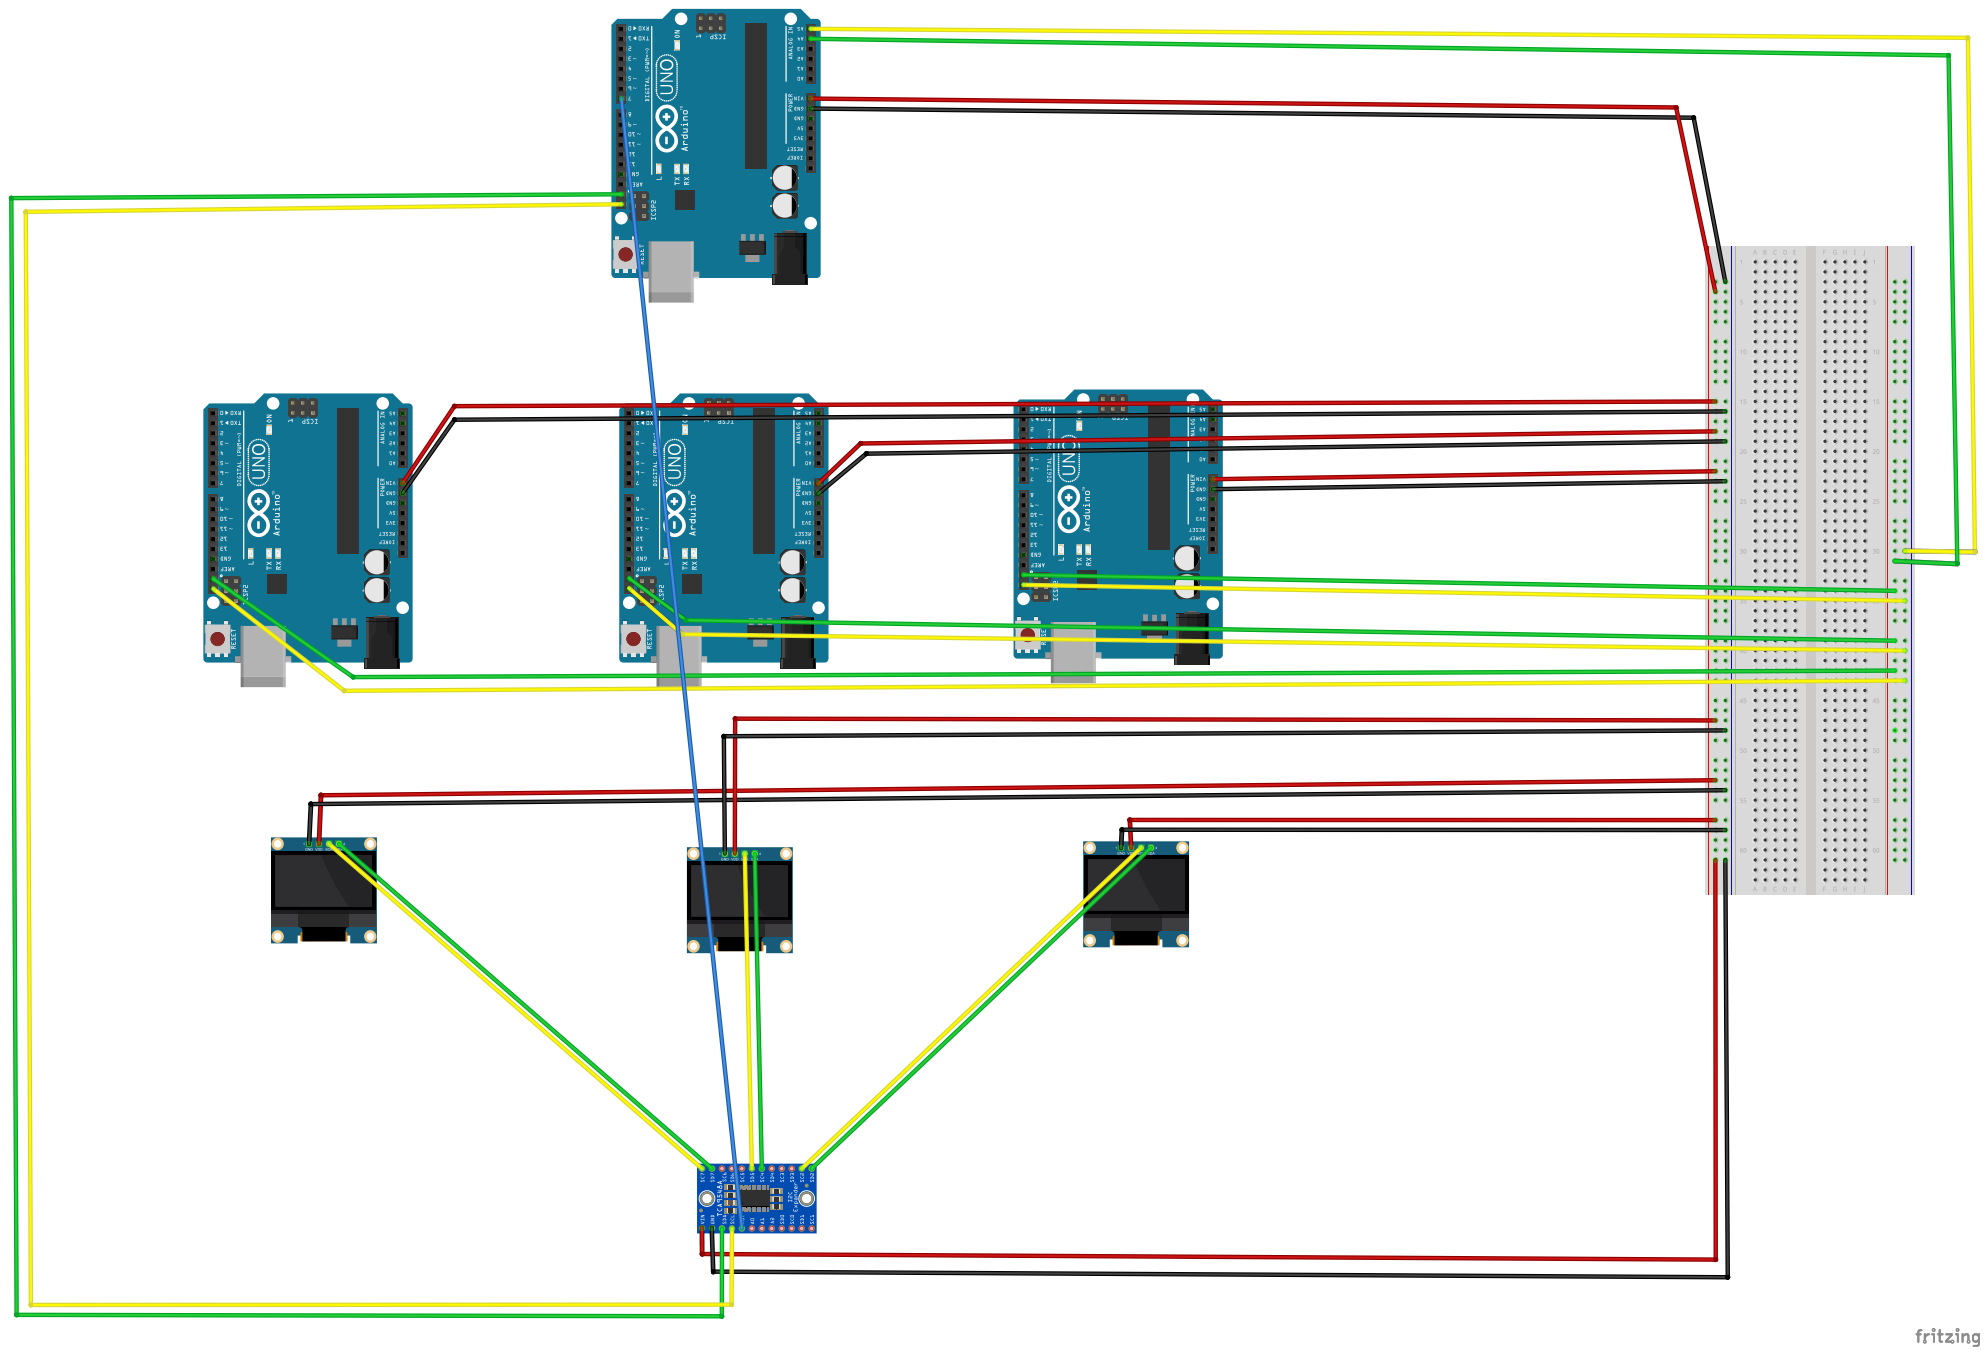
[picture p34: page 1]
