HillChai/SimpleWarehouse/5_Chapter5_RC522/Picture/RFID_RC522.pdf

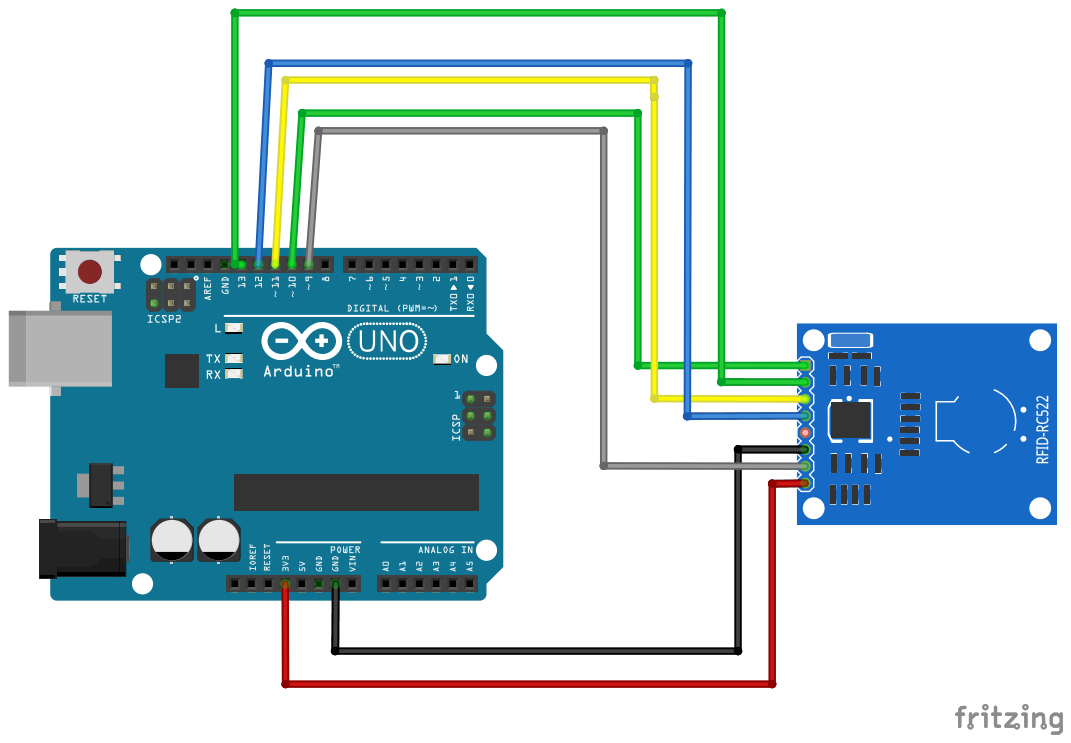
[picture p35: page 1]
