HillChai/SimpleWarehouse/5_Chapter5_RC522/Picture/RFID_RC522_line.pdf

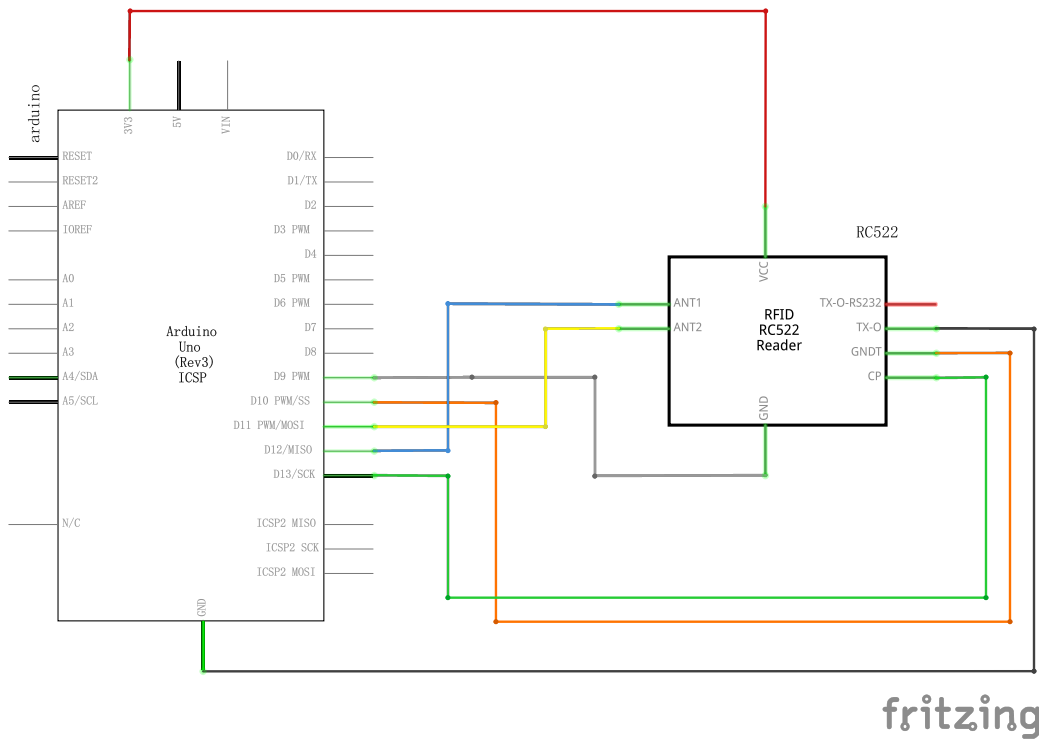
[picture p36: page 1]
