HillChai/SimpleWarehouse/6_Chapter6_UHF_R505/Picture/R505.pdf

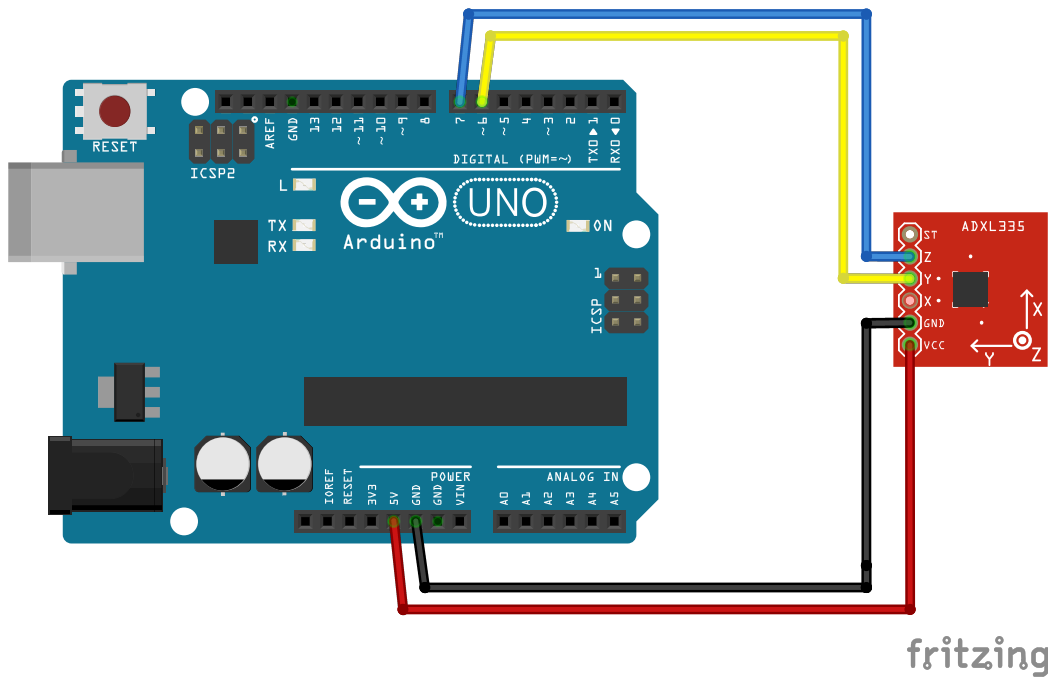
[picture p37: page 1]
