HillChai/SimpleWarehouse/6_Chapter6_UHF_R505/Picture/R505_line.pdf

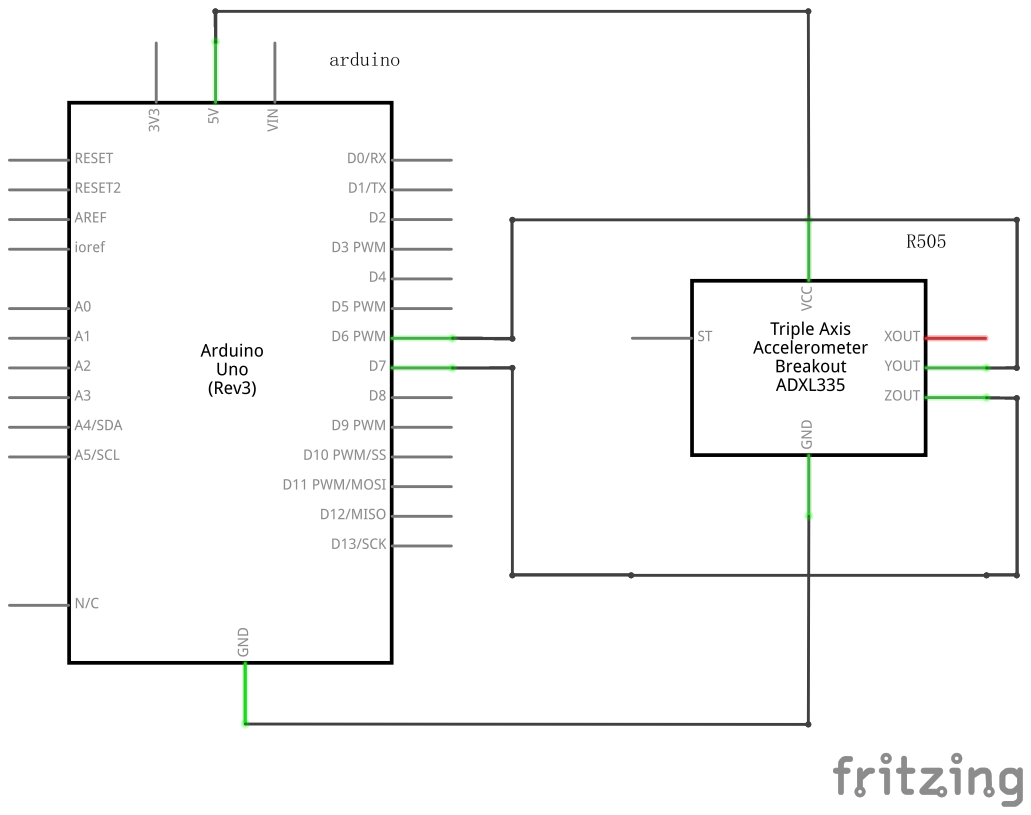
[picture p38: page 1]
