HillChai/SimpleWarehouse/TEX/picture/OLED.pdf

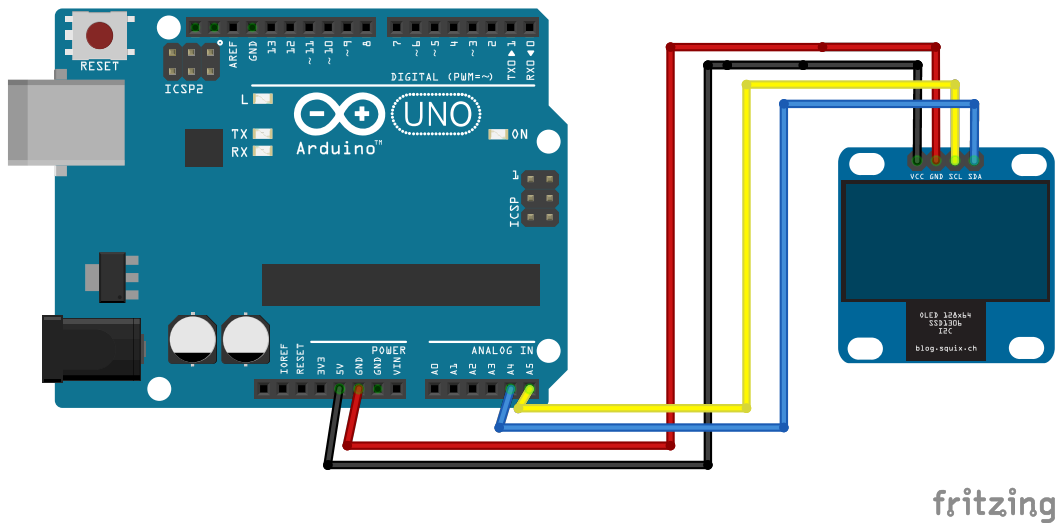
[picture p39: page 1]
