HillChai/SimpleWarehouse/TEX/picture/OLED_line.pdf

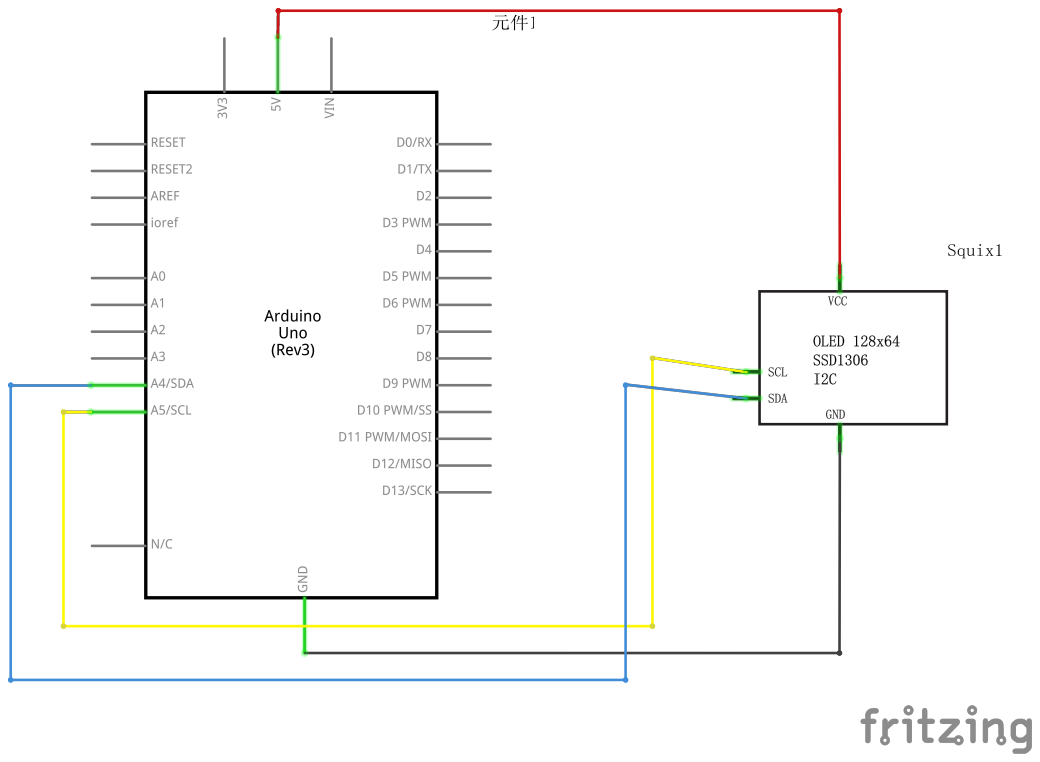
[picture p40: page 1]
