HillChai/SimpleWarehouse/(list of files, drawings)

Other design files:
4_Chapter4_COMMUNICATION/MOS.fzz
4_Chapter4_COMMUNICATION/一层货架示意图.fzz
