HillChai/SimpleWarehouse/4_Chapter4_COMMUNICATION/MOS/Oled.h

#pragma once

#include <Adafruit_GFX.h>
#include <Adafruit_SSD1306.h>

class Oled {
private:
  Adafruit_SSD1306 display;
public:
  void initialize();
  void show(char *type, int num, int i);
  void showIIC(char *type, int num, int i);
};
